See-Insights/Trashcan-Panda-Hardware/Trashcan-Panda-Assembled/IMG_0967.jpeg

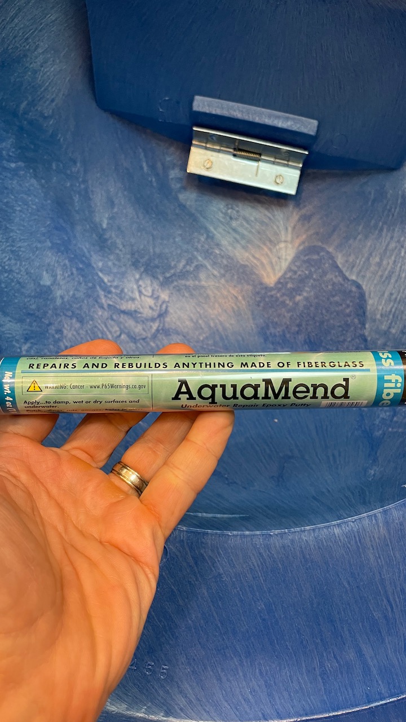
Trashcan-Panda-Assembled/IMG_0967.jpeg
