See-Insights/Trashcan-Panda-Hardware/Trashcan-Panda-Assembled/IMG_0966.jpeg

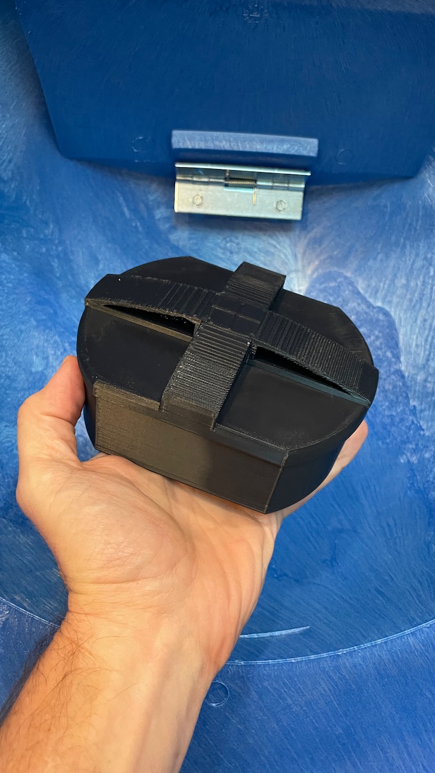
Trashcan-Panda-Assembled/IMG_0966.jpeg
