See-Insights/Trashcan-Panda-Hardware/README.md

# Trashcan-Panda-Hardware
 Trashcan Panda project hardware files
