See-Insights/Trashcan-Panda-Hardware/Trashcan Panda Project Case/images/IMG_1097.png

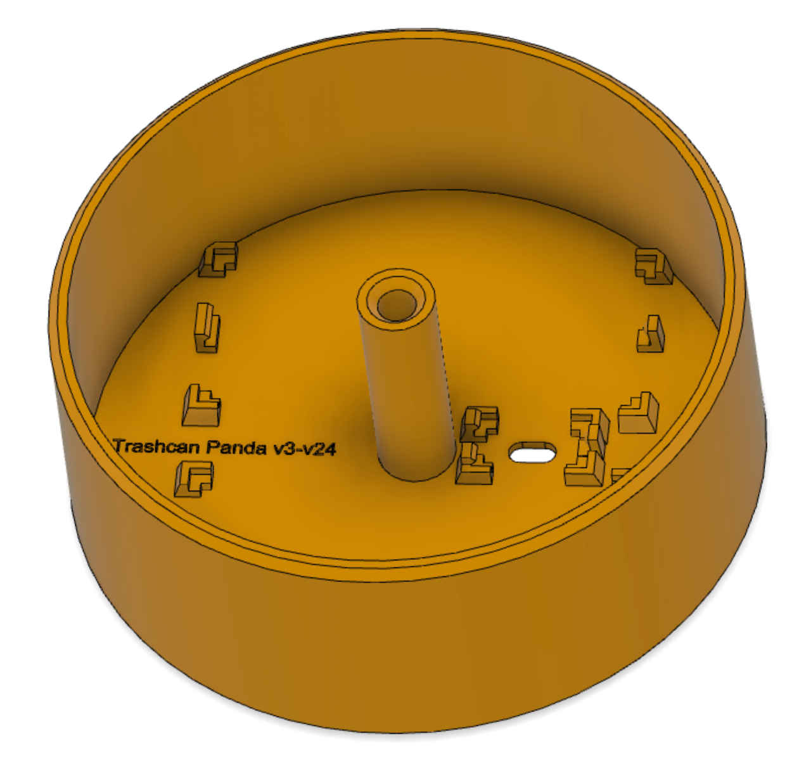
Trashcan Panda Project Case/images/IMG_1097.png
