See-Insights/Trashcan-Panda-Hardware/Trashcan Panda Project Case/images/IMG_5796.png

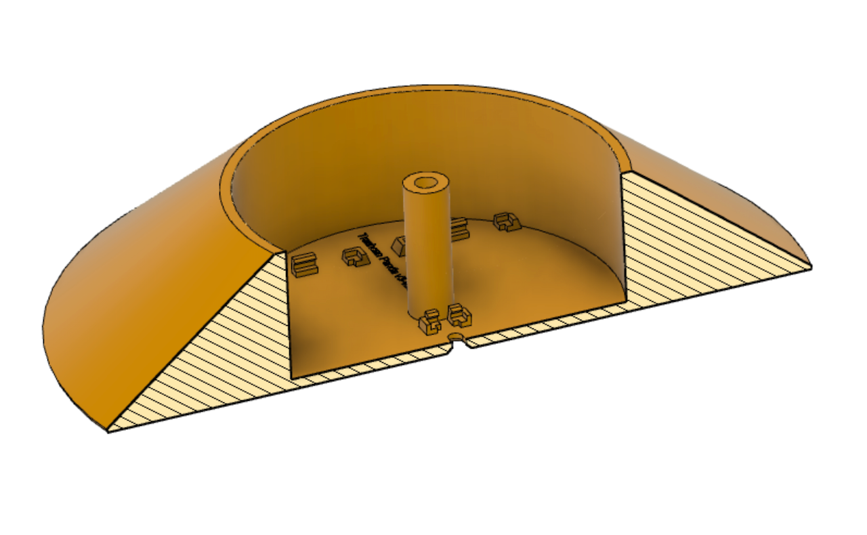
Trashcan Panda Project Case/images/IMG_5796.png
