See-Insights/Trashcan-Panda-Hardware/Trashcan Panda Project Case/images/IMG_8734.png

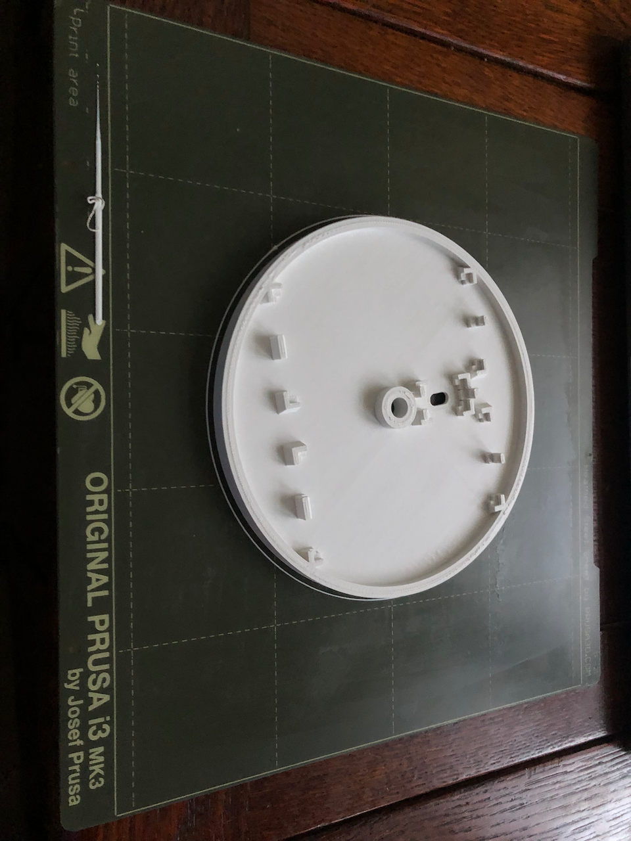
Trashcan Panda Project Case/images/IMG_8734.png
