See-Insights/Trashcan-Panda-Hardware/Trashcan Panda Project Case/images/IMG_8735.png

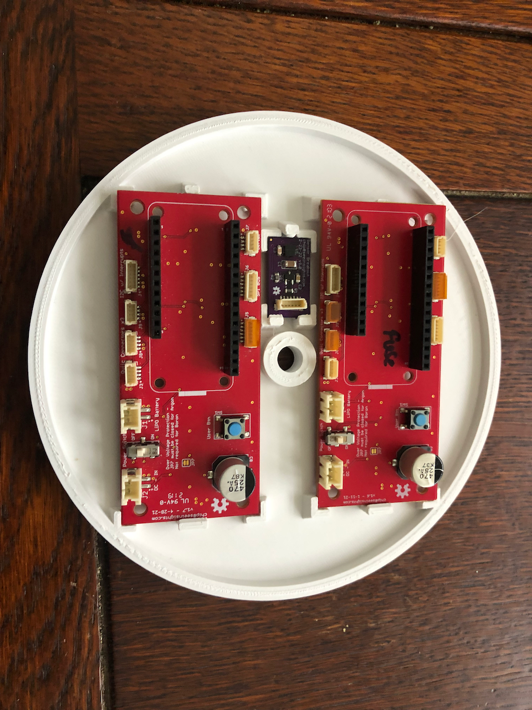
Trashcan Panda Project Case/images/IMG_8735.png
