See-Insights/Trashcan-Panda-Hardware/Trashcan Panda Project Case/images/Screen Shot 2022-02-21 at 4.45.45 PM.png

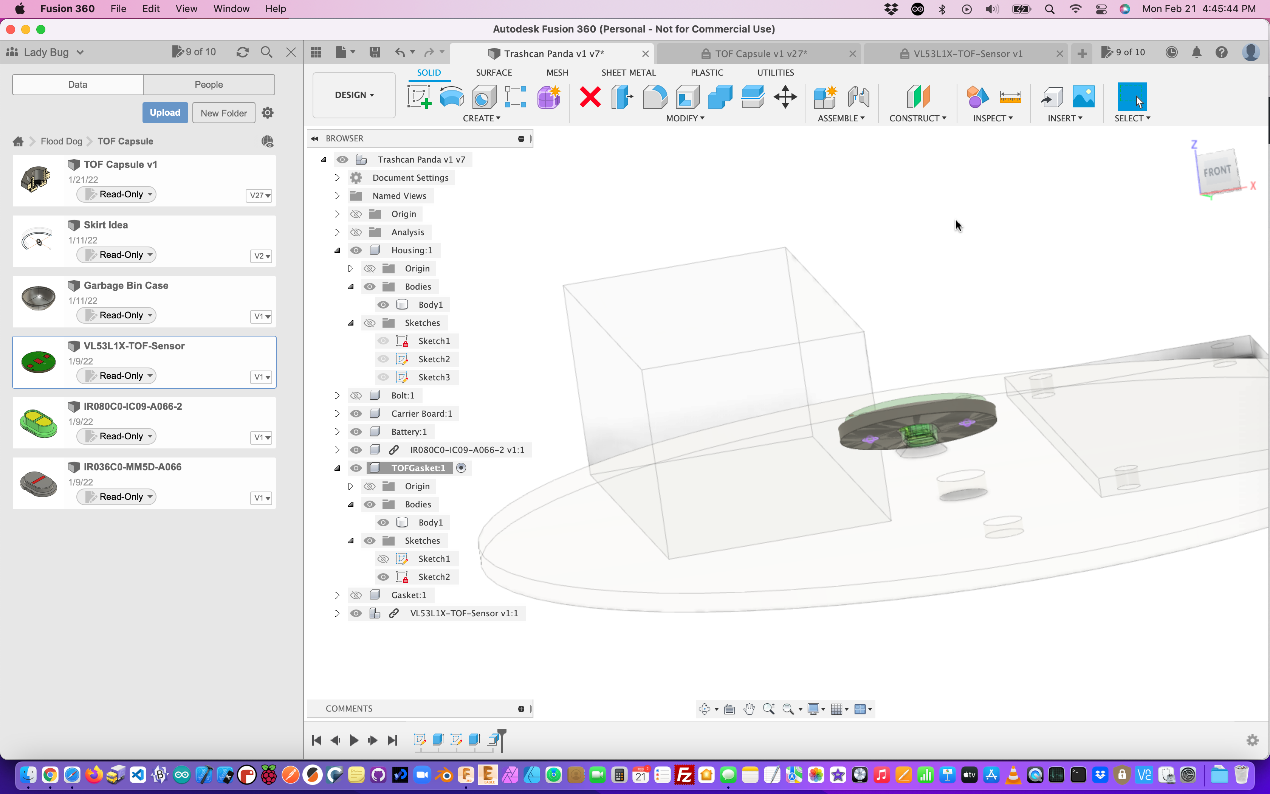
Trashcan Panda Project Case/images/Screen Shot 2022-02-21 at 4.45.45 PM.png
