See-Insights/Trashcan-Panda-Hardware/Trashcan Panda Project Case/images/Screen Shot 2022-02-22 at 7.52.22 AM.png

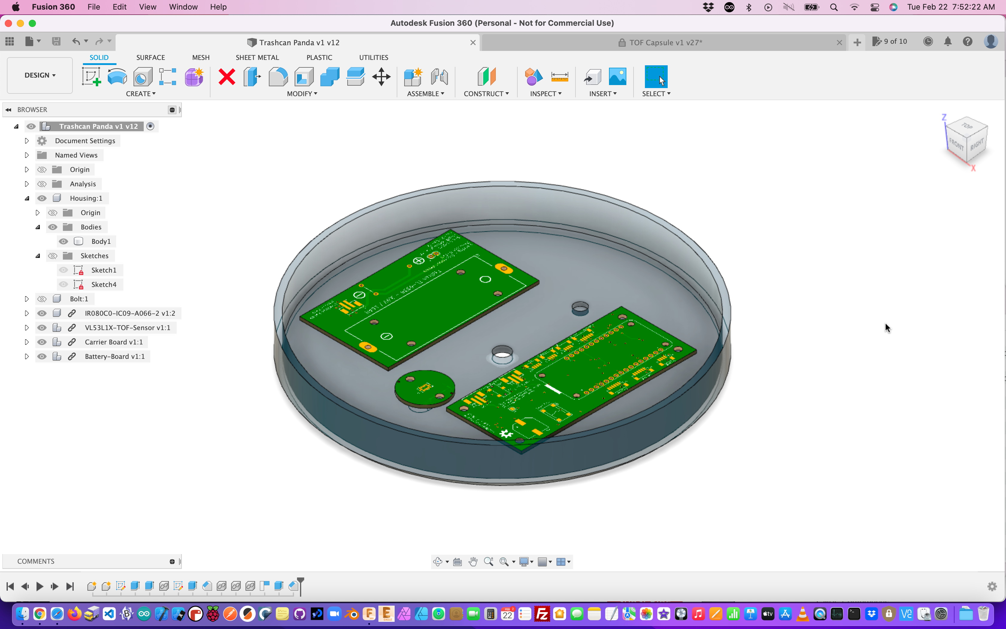
Trashcan Panda Project Case/images/Screen Shot 2022-02-22 at 7.52.22 AM.png
