See-Insights/Trashcan-Panda-Hardware/Trashcan Panda Project Case/images/Screen Shot 2022-02-23 at 12.25.41 PM.png

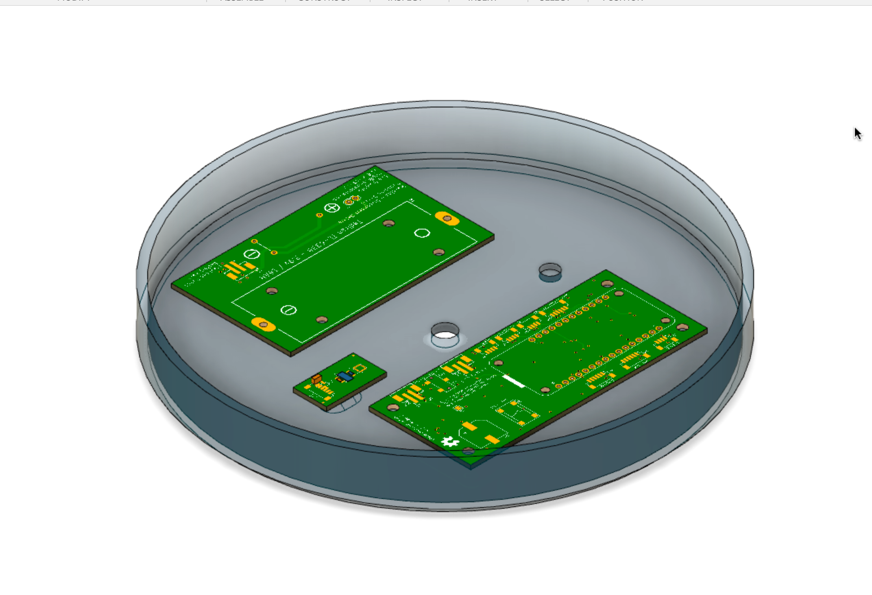
Trashcan Panda Project Case/images/Screen Shot 2022-02-23 at 12.25.41 PM.png
