See-Insights/Trashcan-Panda-Hardware/Trashcan Panda Project Case/images/Screen Shot 2022-02-24 at 10.45.38 AM.png

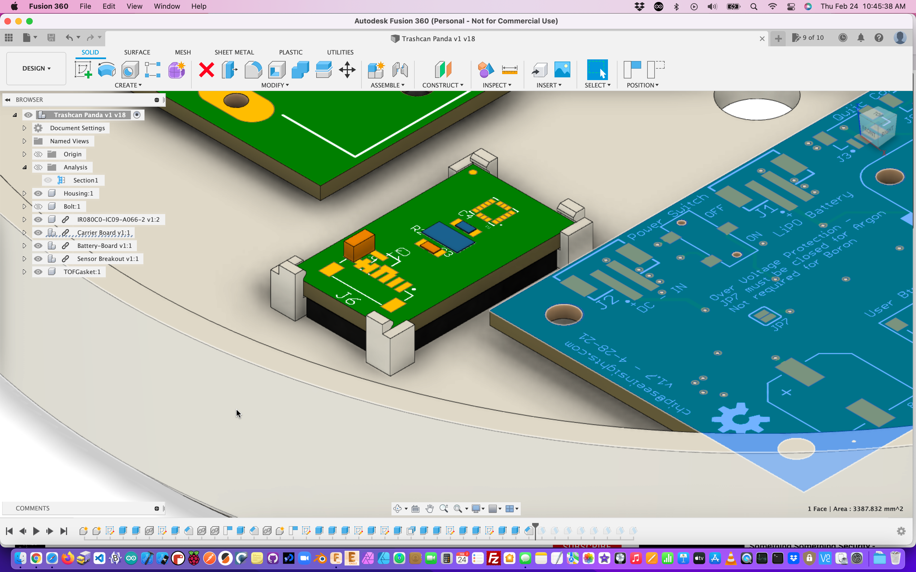
Trashcan Panda Project Case/images/Screen Shot 2022-02-24 at 10.45.38 AM.png
