See-Insights/Trashcan-Panda-Hardware/Trashcan Panda Project Case/images/Screen Shot 2022-02-24 at 10.49.25 AM.png

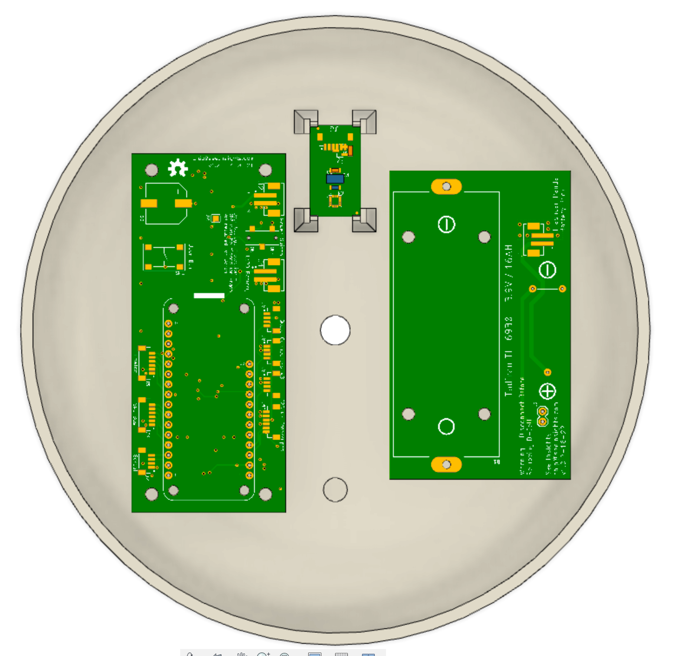
Trashcan Panda Project Case/images/Screen Shot 2022-02-24 at 10.49.25 AM.png
