See-Insights/Trashcan-Panda-Hardware/Trashcan Panda Project Case/images/Screen Shot 2022-02-24 at 11.52.08 AM.png

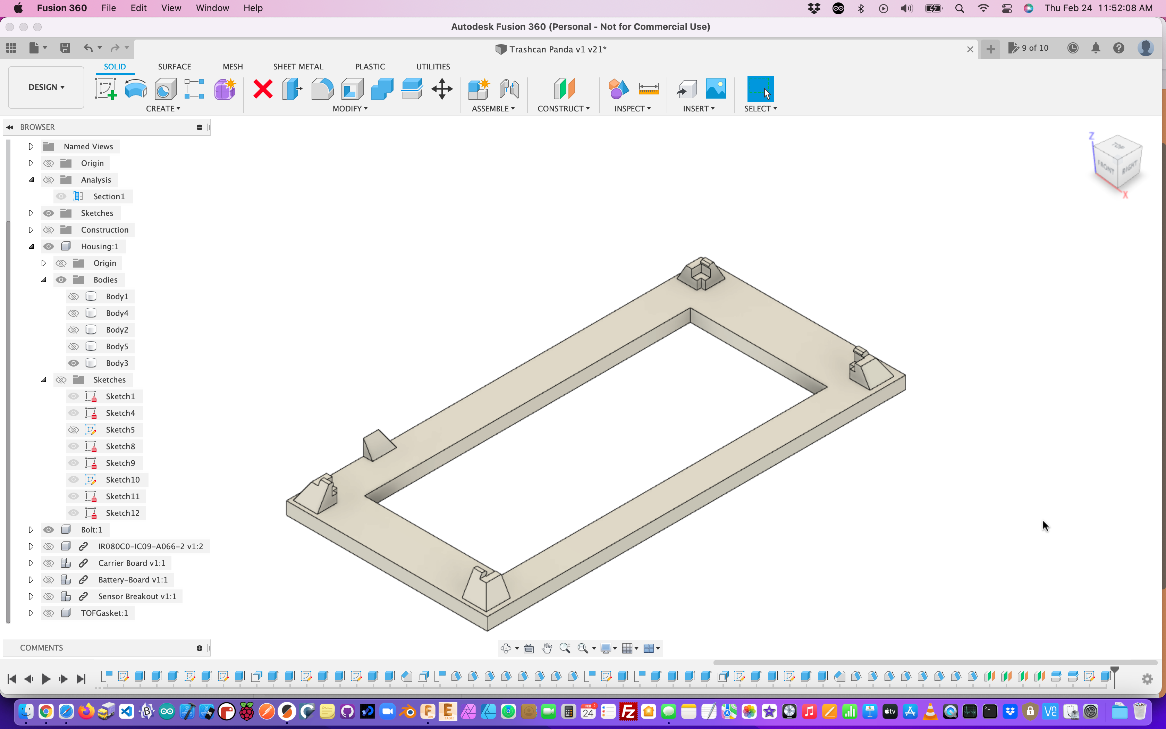
Trashcan Panda Project Case/images/Screen Shot 2022-02-24 at 11.52.08 AM.png
