See-Insights/Trashcan-Panda-Hardware/Trashcan Panda Project Case/images/Screen Shot 2022-02-25 at 9.09.44 AM.png

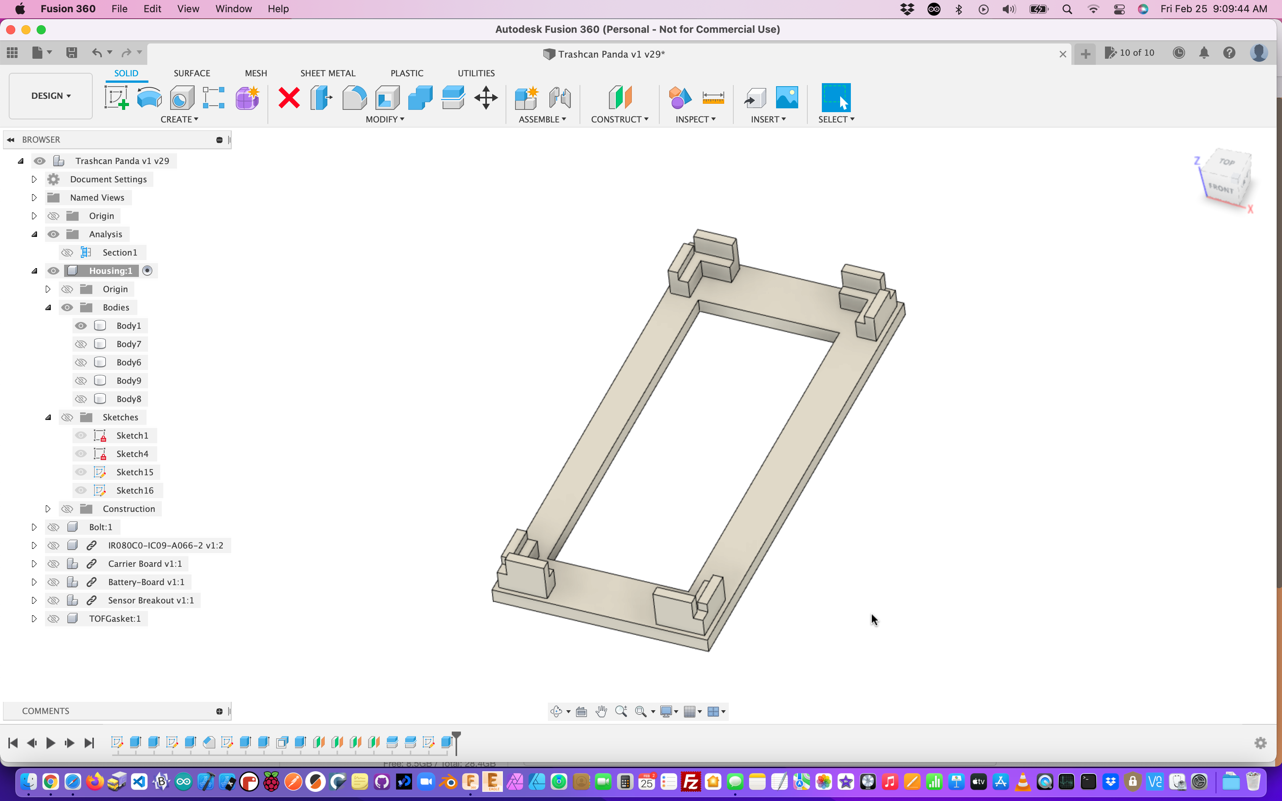
Trashcan Panda Project Case/images/Screen Shot 2022-02-25 at 9.09.44 AM.png
