See-Insights/Trashcan-Panda-Hardware/Trashcan Panda Project Case/images/Screen Shot 2022-02-26 at 8.32.29 AM.png

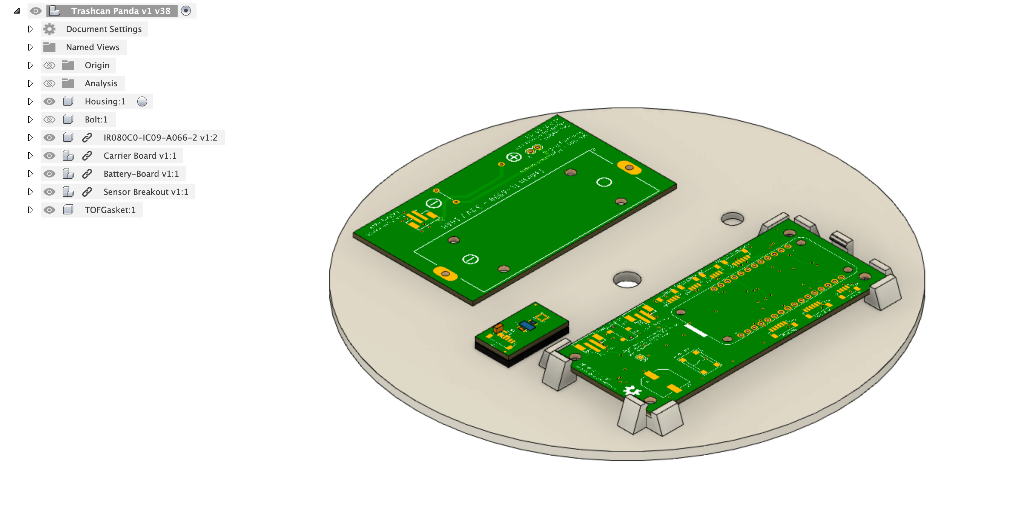
Trashcan Panda Project Case/images/Screen Shot 2022-02-26 at 8.32.29 AM.png
