See-Insights/Trashcan-Panda-Hardware/Trashcan-Panda Sensor-Board/Sensor Breakout Bottom.png

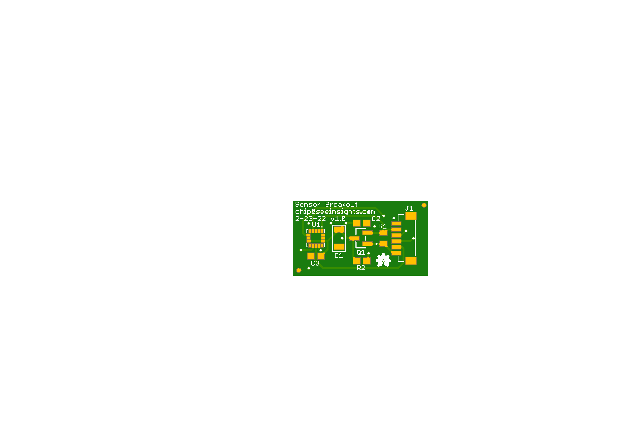
Trashcan-Panda Sensor-Board/Sensor Breakout Bottom.png
