See-Insights/Trashcan-Panda-Hardware/Trashcan-Panda Sensor-Board/Sensor Breakout Top Board.png

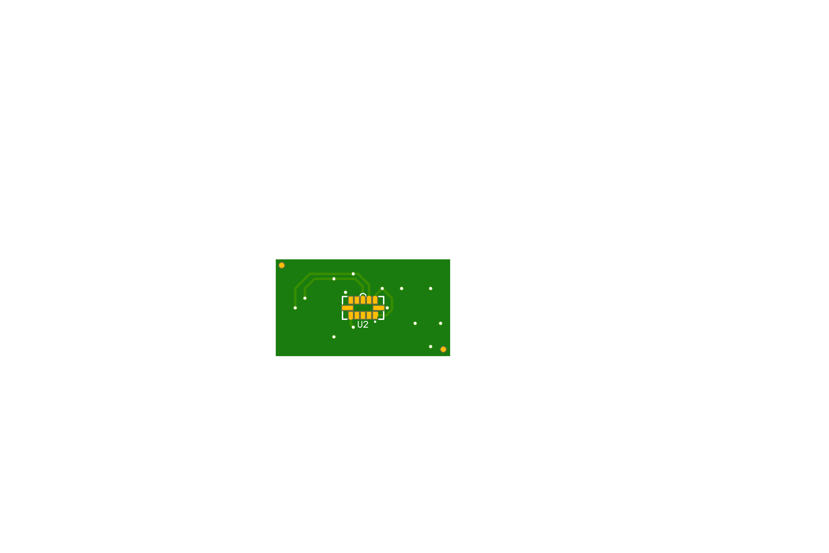
Trashcan-Panda Sensor-Board/Sensor Breakout Top Board.png
