See-Insights/Trashcan-Panda-Hardware/Trashcan Panda Project Case/Trashcan Panda v6 v27.3mf

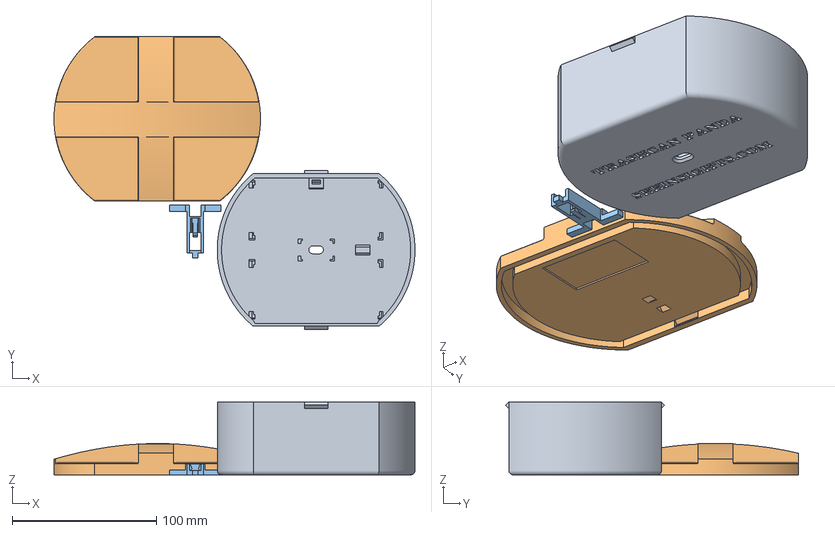
[picture p22: CAD file, 2022-05-29]
Trashcan Panda Project Case/Trashcan Panda v6 v27.3mf
250.0 x 202.6 x 50.4 mm
Housing
Lid
T Bracket
