See-Insights/Trashcan-Panda-Hardware/Trashcan Panda v6 v4.3mf

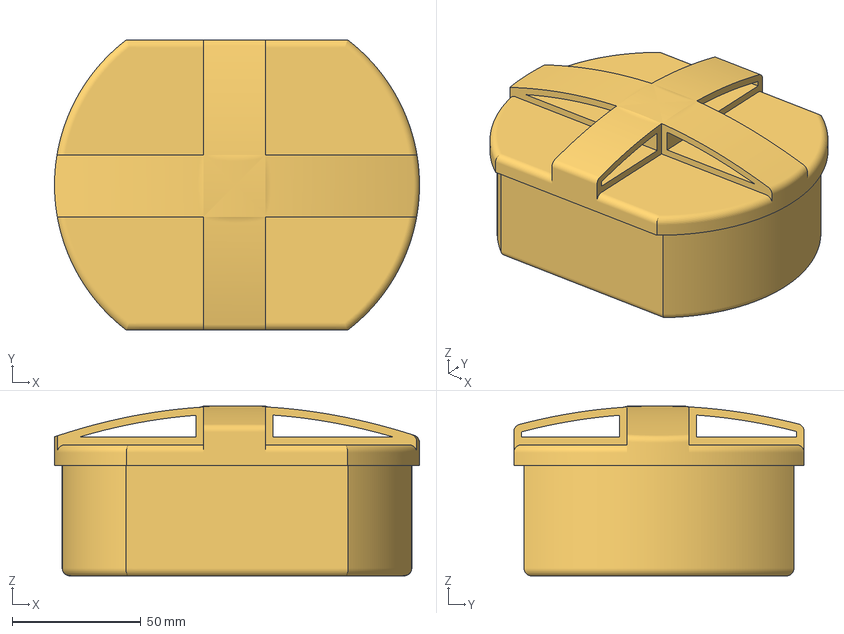
[picture p23: CAD file, 2022-05-03]
Trashcan Panda v6 v4.3mf
142.0 x 113.0 x 66.1 mm
Housing
Lid Seal
Lid
T Bracket
TOF Gasket
