See-Insights/Trashcan-Panda-Hardware/Trashcan-Panda Sensor-Board/3D Models/VL53L1CBV0FY-1--3DModel-STEP-269445.STEP

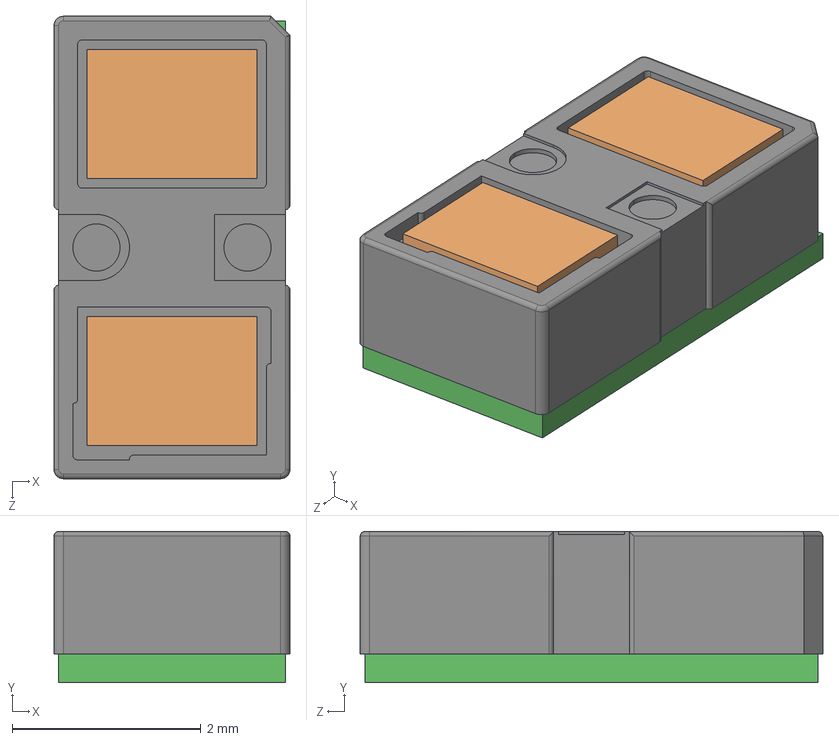
[picture p24: CAD file, 2022-02-18]
Trashcan-Panda Sensor-Board/3D Models/VL53L1CBV0FY-1--3DModel-STEP-269445.STEP
2.50 x 1.60 x 4.90 mm
