See-Insights/Trashcan-Panda-Hardware/Trashcan Panda Project Case/Trashcan Panda v6 Flat Lid v27.3mf

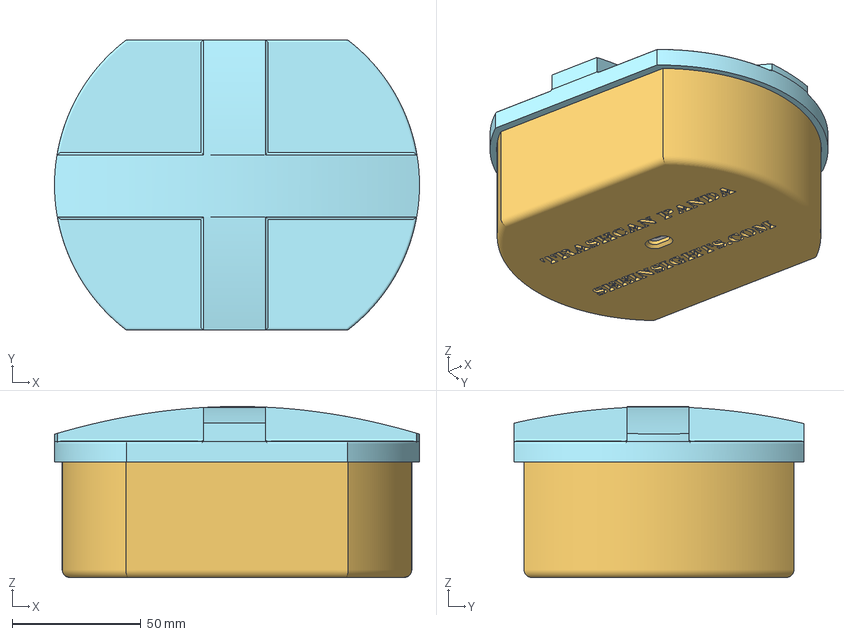
[picture p25: CAD file, 2022-05-29]
Trashcan Panda Project Case/Trashcan Panda v6 Flat Lid v27.3mf
142.0 x 113.0 x 66.5 mm
Battery Brace
Housing
Lid (3)
Lid Seal
Lid
T Bracket
TOF Gasket
