See-Insights/Trashcan-Panda-Hardware/Trashcan Panda Project Case/Trashcan Panda v6 v6.3mf

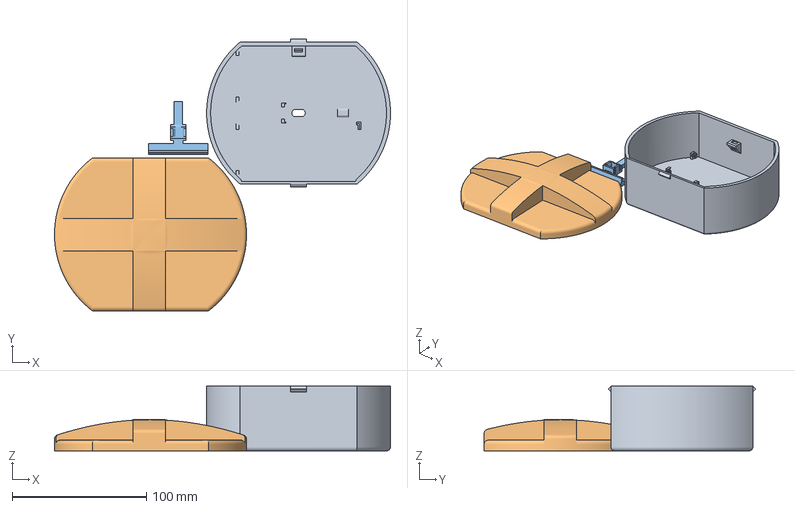
[picture p26: CAD file, 2022-05-04]
Trashcan Panda Project Case/Trashcan Panda v6 v6.3mf
250.0 x 202.1 x 48.3 mm
Housing
Lid
T Bracket
