See-Insights/Trashcan-Panda-Hardware/Trashcan Panda Project Case/Trashcan Panda v6 v4.3mf

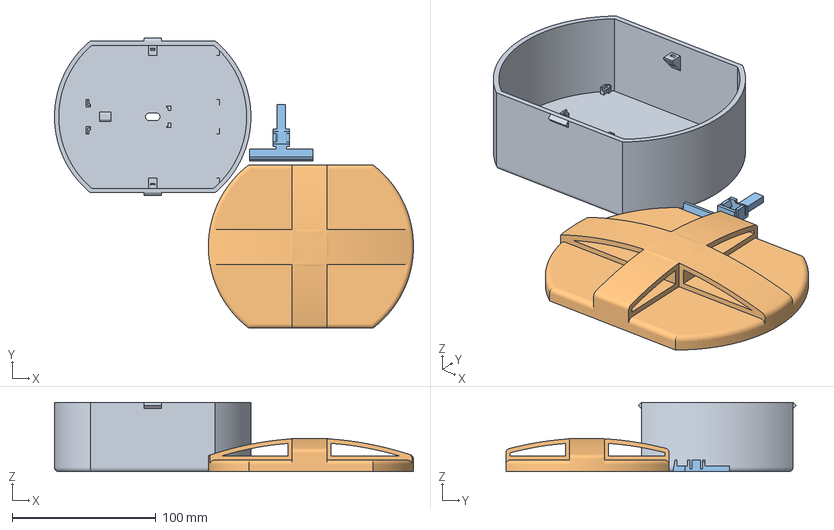
[picture p27: CAD file, 2022-05-03]
Trashcan Panda Project Case/Trashcan Panda v6 v4.3mf
250.0 x 202.1 x 48.3 mm
Housing
Lid
T Bracket
