See-Insights/Trashcan-Panda-Hardware/Trashcan Panda Project Case/Trashcan Panda v4 v12.3mf

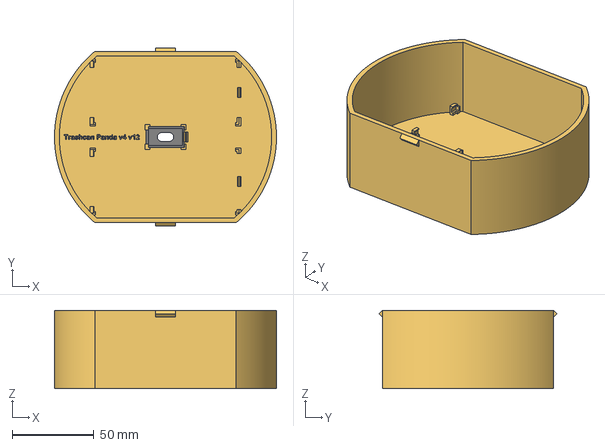
[picture p28: CAD file, 2022-04-23]
Trashcan Panda Project Case/Trashcan Panda v4 v12.3mf
136.0 x 109.2 x 48.0 mm
Housing
TOF Gasket
