See-Insights/Trashcan-Panda-Hardware/Trashcan Panda Project Case/Mount.3mf

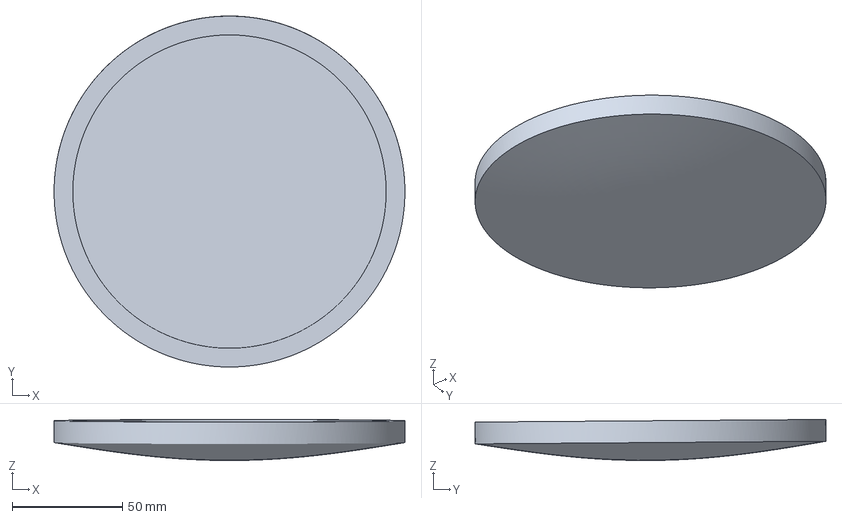
[picture p29: CAD file, 2022-04-11]
Trashcan Panda Project Case/Mount.3mf
159.0 x 159.1 x 18.6 mm
