See-Insights/Trashcan-Panda-Hardware/Trashcan Panda Project Case/Trashcan Panda v3 v28.3mf

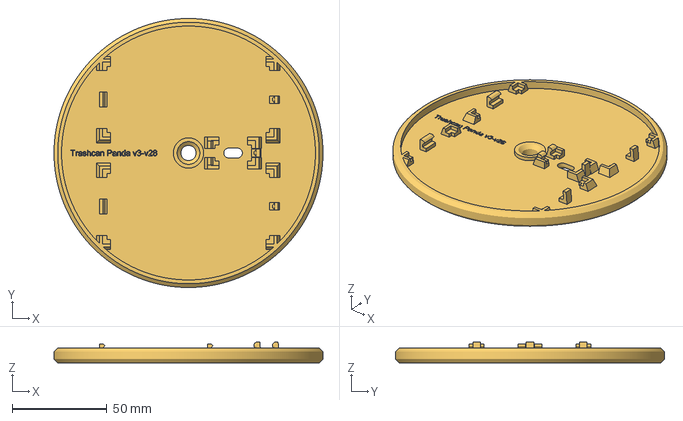
[picture p30: CAD file, 2022-04-09]
Trashcan Panda Project Case/Trashcan Panda v3 v28.3mf
142.0 x 142.0 x 11.0 mm
