See-Insights/Trashcan-Panda-Hardware/Trashcan Panda Project Case/Trashcan Panda v3 v5.3mf

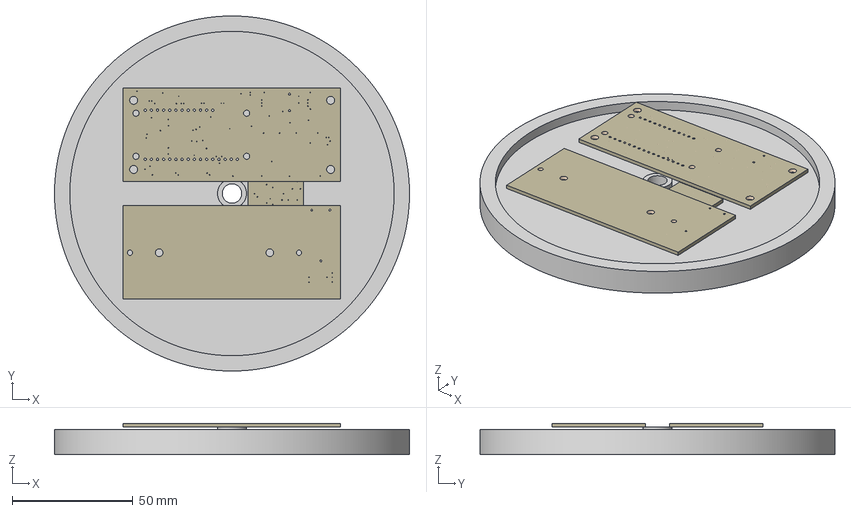
[picture p31: CAD file, 2022-03-21]
Trashcan Panda Project Case/Trashcan Panda v3 v5.3mf
146.7 x 146.7 x 12.9 mm
Board x 3
Housing
