See-Insights/Trashcan-Panda-Hardware/Trashcan Panda Project Case/Trashcan Panda v2 v9.3mf

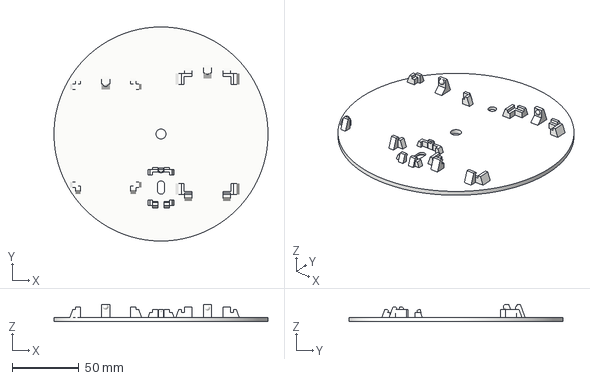
[picture p32: CAD file, 2022-03-16]
Trashcan Panda Project Case/Trashcan Panda v2 v9.3mf
160.0 x 160.0 x 13.0 mm
