See-Insights/Trashcan-Panda-Hardware/Trashcan Panda Project Case/Trashcan Panda v1 v12.3mf

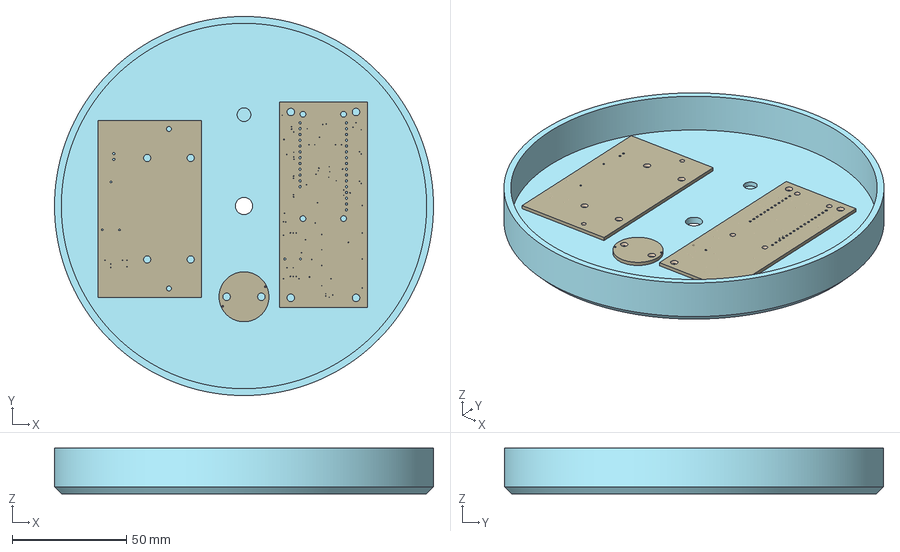
[picture p33: CAD file, 2022-02-23, an earlier design]
Trashcan Panda Project Case/Trashcan Panda v1 v12.3mf
166.0 x 166.0 x 20.0 mm
0805@1 x 7
Board x 3
CAPC2012X100N
MICRO-FIDUCIAL x 4
PANASONIC_SMINI2-F5-B
QFN_16_ABR
RJ_5_ADI
SOD-123 x 2
SON50P200X300X75-9N
SOT-23-5
SOT-23_3L_ONS
SOT-23_3L_ONS-M x 2
SOT-25_TOR
SSP-T7-F_EPS
