See-Insights/Trashcan-Panda-Hardware/Trashcan Panda Project Case/Trashcan Panda v1 v6.3mf

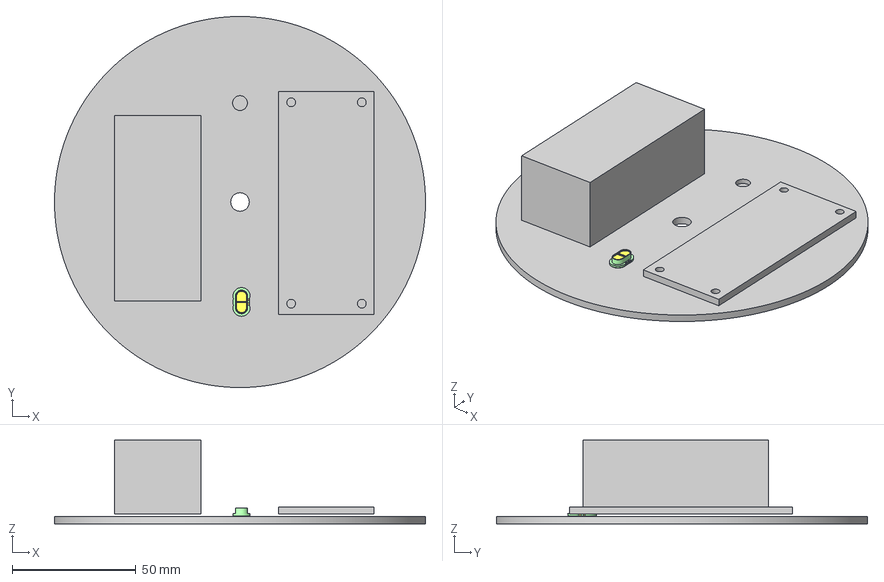
[picture p34: CAD file, 2022-02-18, an earlier design]
Trashcan Panda Project Case/Trashcan Panda v1 v6.3mf
150.0 x 150.0 x 33.9 mm
