See-Insights/Trashcan-Panda-Hardware/(list of files, cad)

Other CAD files:
Trashcan Panda Project Case/Trashcan Panda v6 v3.3mf
Trashcan Panda Project Case/Trashcan Panda v1 v12.f3z
Trashcan Panda Project Case/Trashcan Panda v1 v39.f3z
Trashcan Panda Project Case/Trashcan Panda v1 v6.f3z
Trashcan Panda Project Case/Trashcan Panda v2 v9.f3z
Trashcan Panda Project Case/Trashcan Panda v6 v28.f3z
Trashcan Panda Project Case/Trashcan Panda v6 v3.f3z
Trashcan Panda Project Case/Trashcan Panda v6 v4.f3z
Trashcan Panda Project Case/Trashcan Panda v6 v6.f3z
Trashcan-Panda Sensor-Board/3D Models/TOF Capsule v1 v8.f3z
