See-Insights/Trashcan-Panda-Hardware/Trashcan-Panda-Assembled/IMG_0960.jpeg

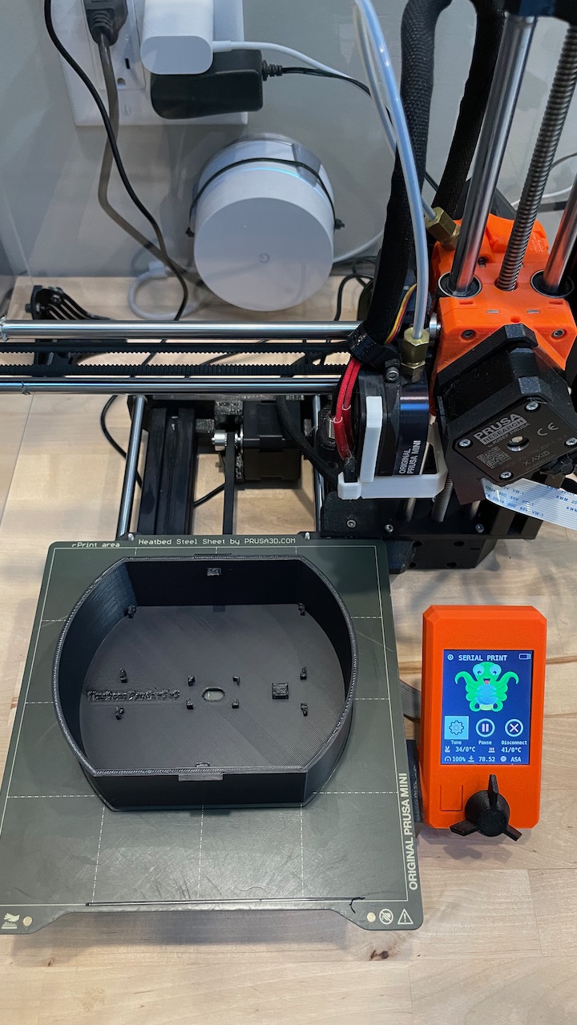
Trashcan-Panda-Assembled/IMG_0960.jpeg
