See-Insights/Trashcan-Panda-Hardware/Trashcan-Panda-Assembled/IMG_0965.jpeg

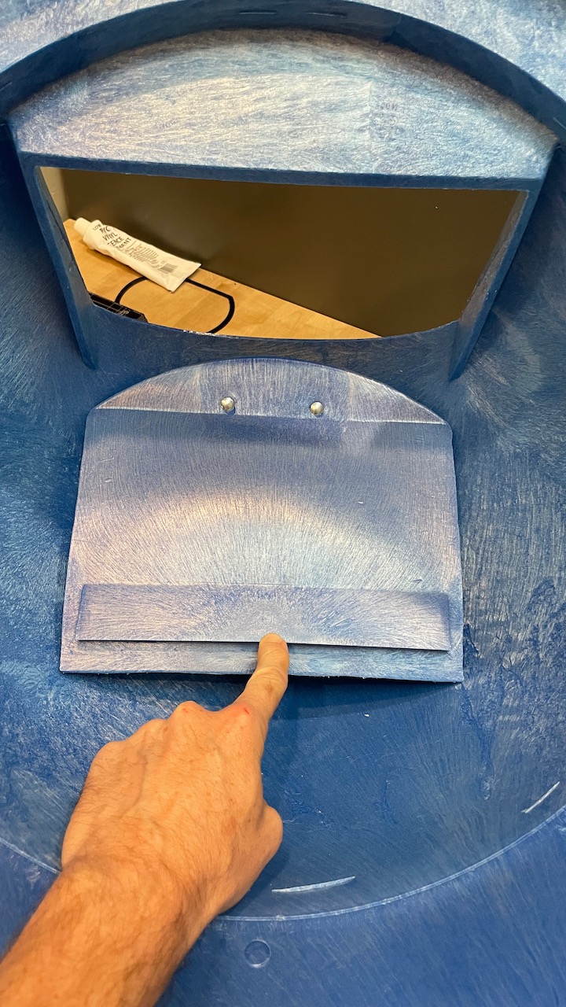
Trashcan-Panda-Assembled/IMG_0965.jpeg
