See-Insights/Trashcan-Panda-Hardware/Trashcan-Panda-Assembled/IMG_0968.jpeg

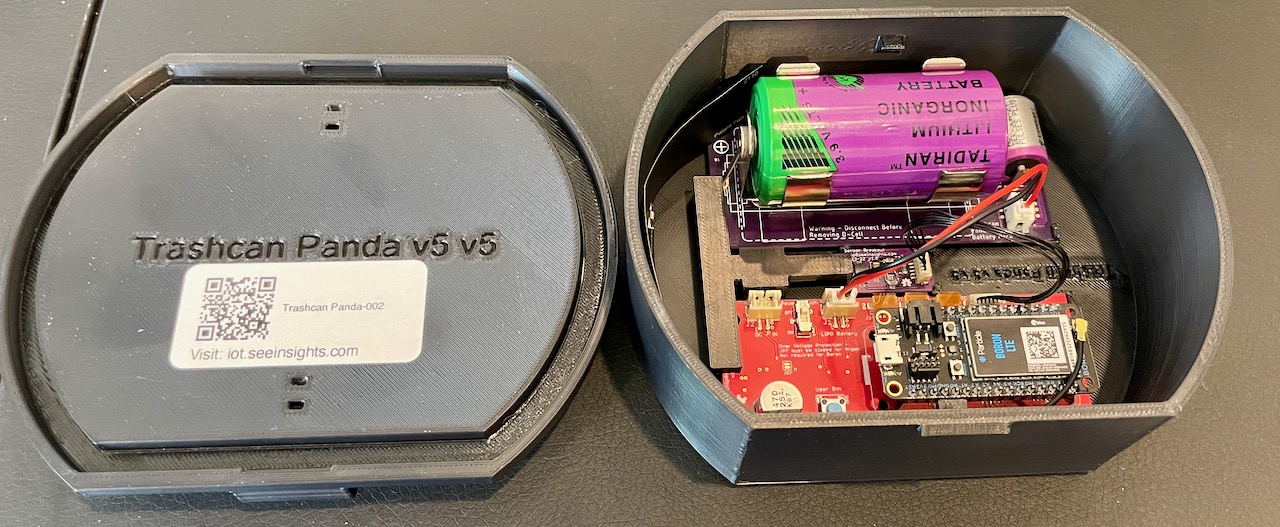
Trashcan-Panda-Assembled/IMG_0968.jpeg
