See-Insights/Trashcan-Panda-Hardware/Trashcan-Panda-Assembled/IMG_0969.jpeg

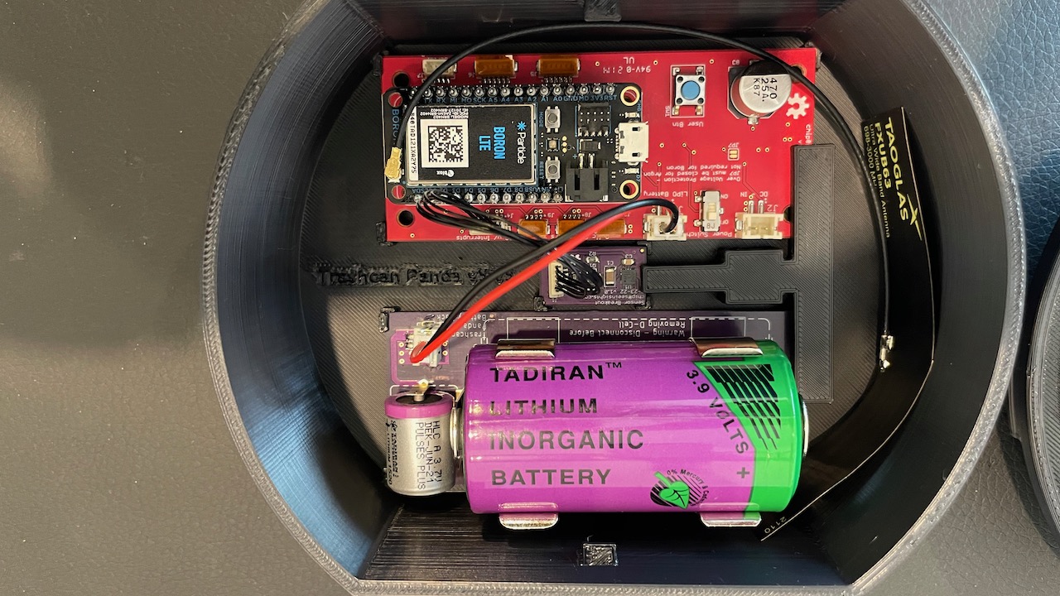
Trashcan-Panda-Assembled/IMG_0969.jpeg
