See-Insights/Trashcan-Panda-Hardware/Trashcan-Panda-Assembled/IMG_0970.jpeg

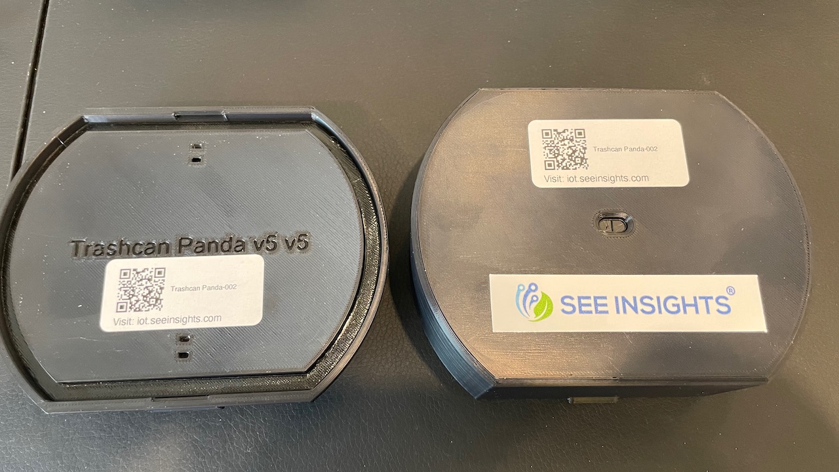
Trashcan-Panda-Assembled/IMG_0970.jpeg
