See-Insights/Trashcan-Panda-Hardware/Trashcan-Panda-Assembled/IMG_0971.jpeg

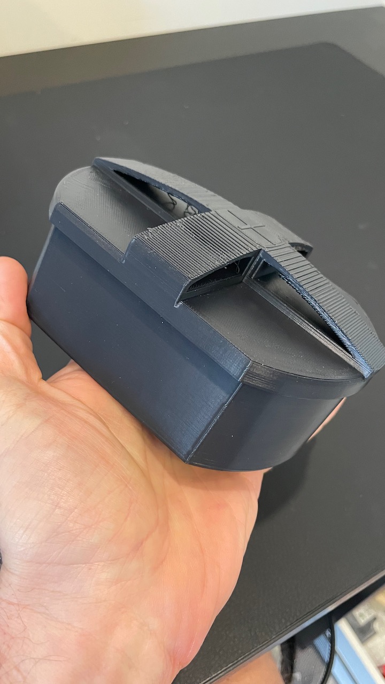
Trashcan-Panda-Assembled/IMG_0971.jpeg
