See-Insights/Trashcan-Panda-Hardware/Trasncan-Panda-Carrier-Board/Carrier Board Schematic.pdf

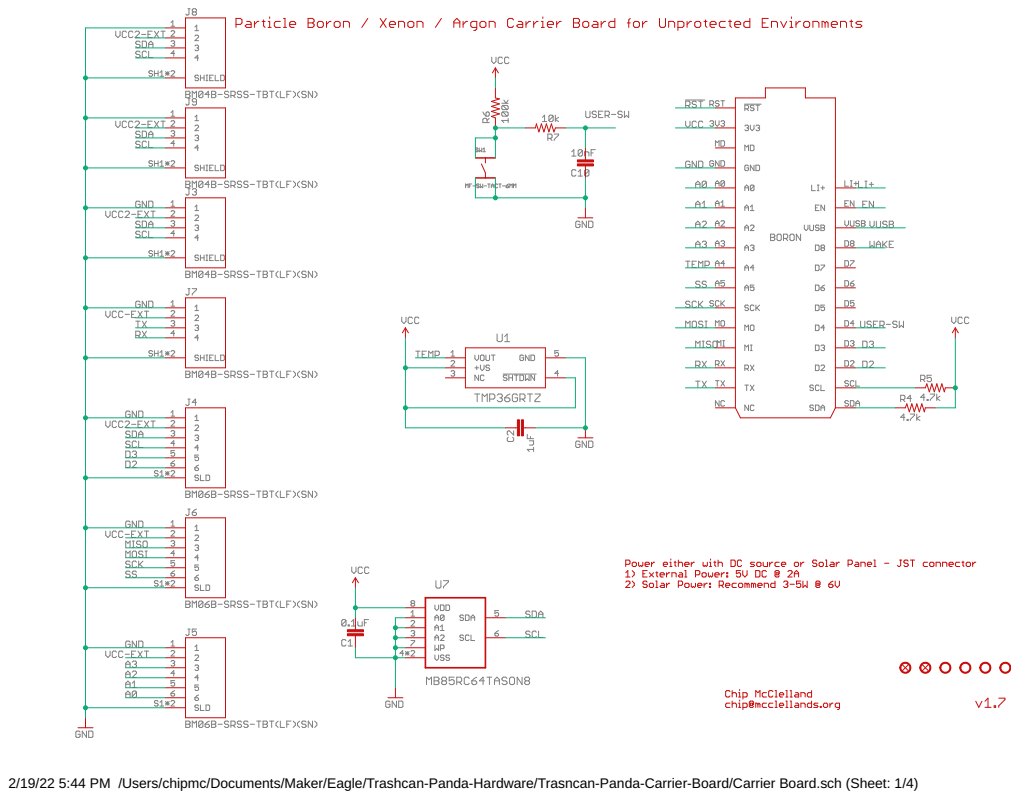
[picture p41: page 1]

2/19/22 5:44 PM /Users/chipmc/Documents/Maker/Eagle/Trashcan-Panda-Hardware/Trasncan-Panda-Carrier-Board/Carrier Board.sch (Sheet: 1/4)

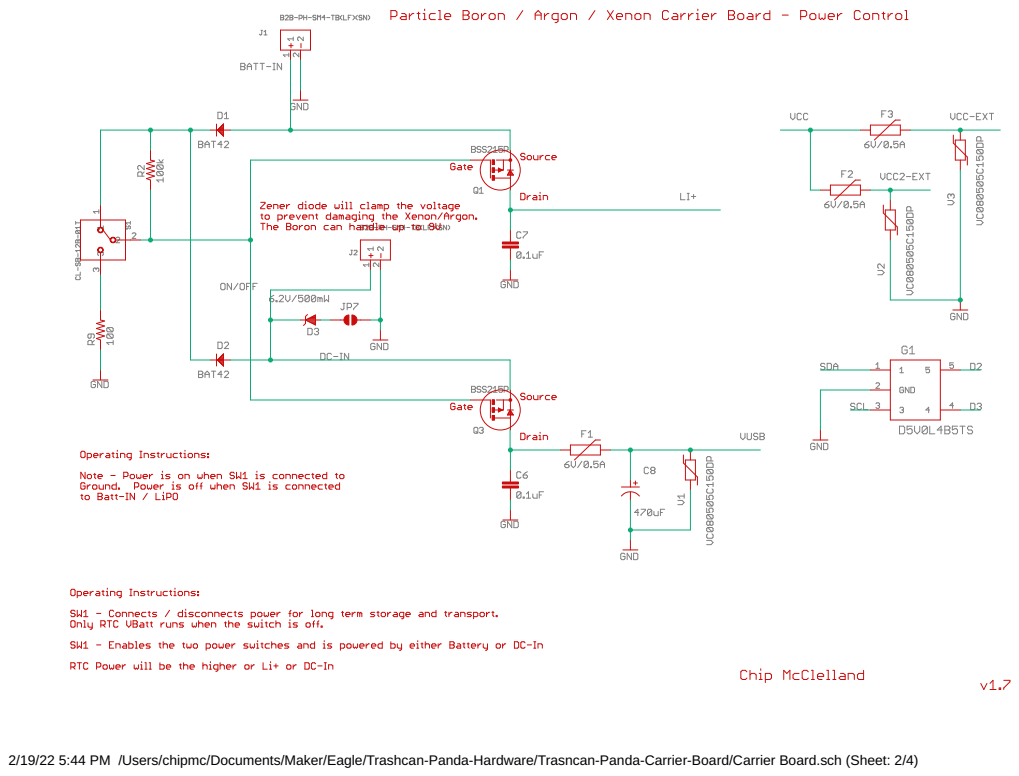
[picture p42: page 2]

2/19/22 5:44 PM /Users/chipmc/Documents/Maker/Eagle/Trashcan-Panda-Hardware/Trasncan-Panda-Carrier-Board/Carrier Board.sch (Sheet: 2/4)

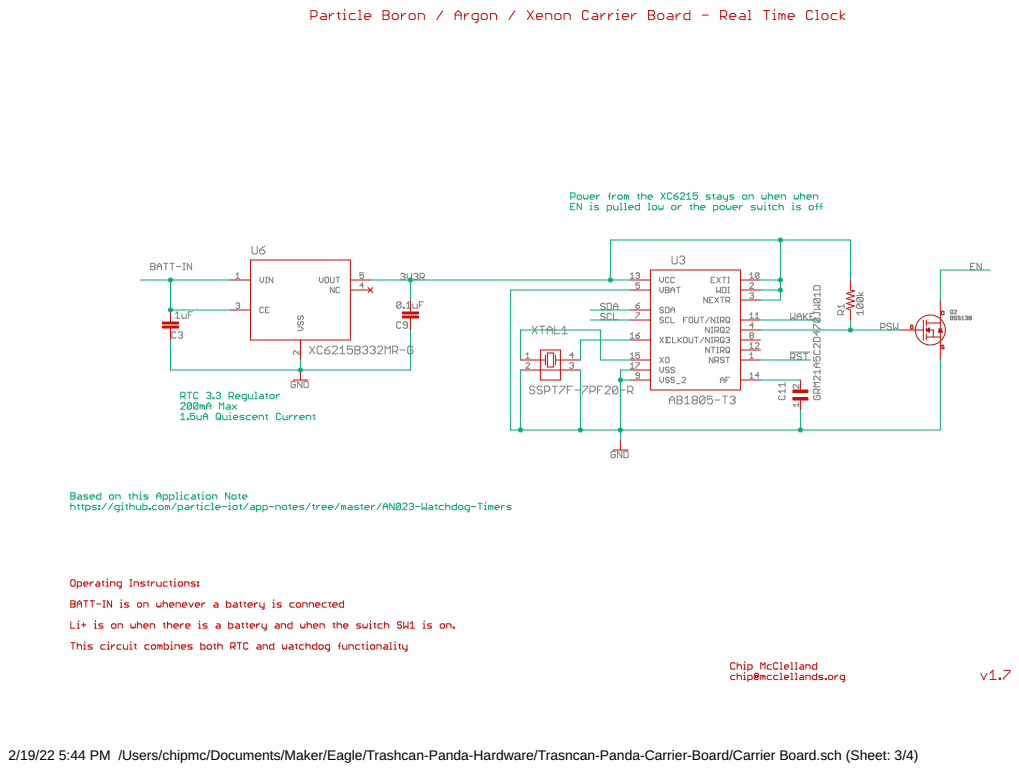
[picture p43: page 3]

2/19/22 5:44 PM /Users/chipmc/Documents/Maker/Eagle/Trashcan-Panda-Hardware/Trasncan-Panda-Carrier-Board/Carrier Board.sch (Sheet: 3/4)

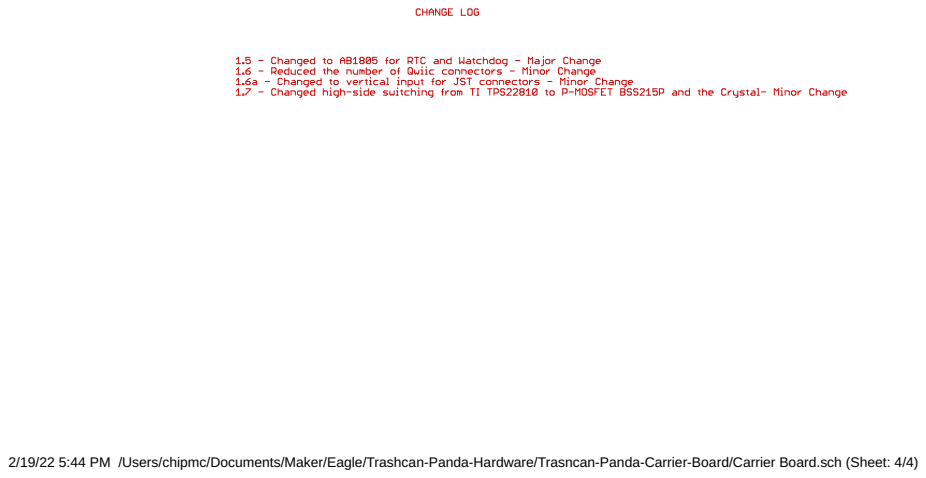
[picture p44: page 4]

2/19/22 5:44 PM /Users/chipmc/Documents/Maker/Eagle/Trashcan-Panda-Hardware/Trasncan-Panda-Carrier-Board/Carrier Board.sch (Sheet: 4/4)
