See-Insights/Trashcan-Panda-Hardware/Trashcan-Panda Sensor-Board/Sensor Breakout.pdf

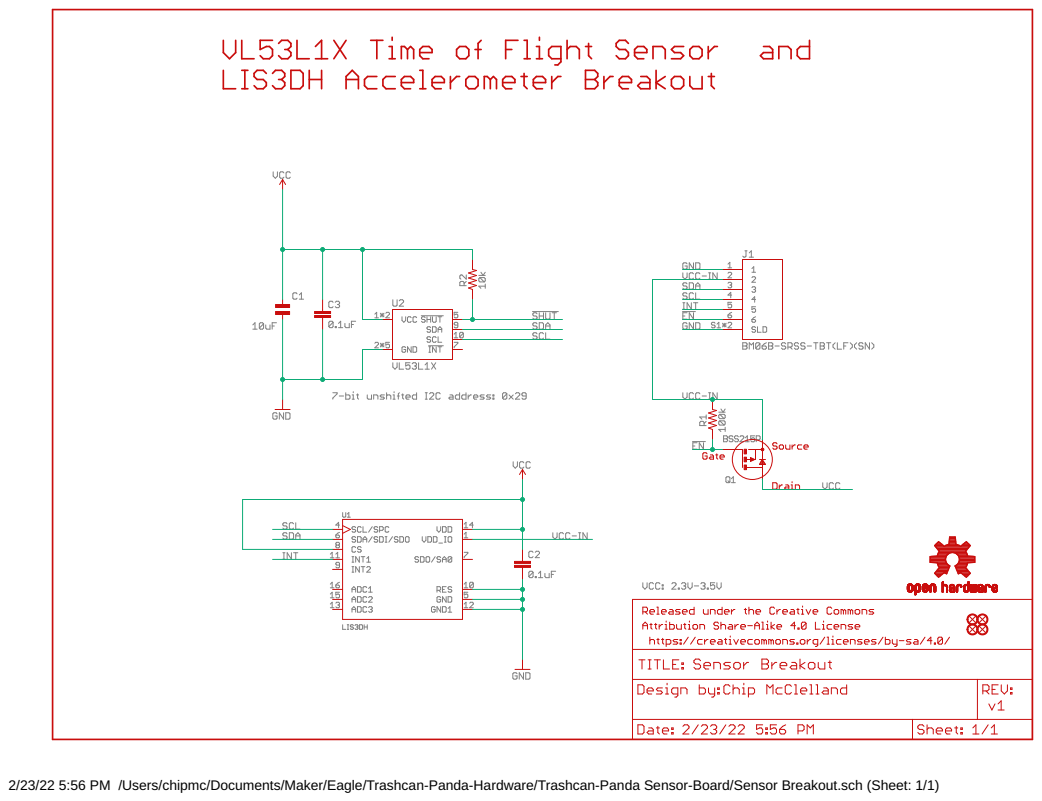
[picture p45: page 1]

2/23/22 5:56 PM /Users/chipmc/Documents/Maker/Eagle/Trashcan-Panda-Hardware/Trashcan-Panda Sensor-Board/Sensor Breakout.sch (Sheet: 1/1)
