See-Insights/Trashcan-Panda-Hardware/Trasncan-Panda-Carrier-Board/Carrier Board Layout.pdf

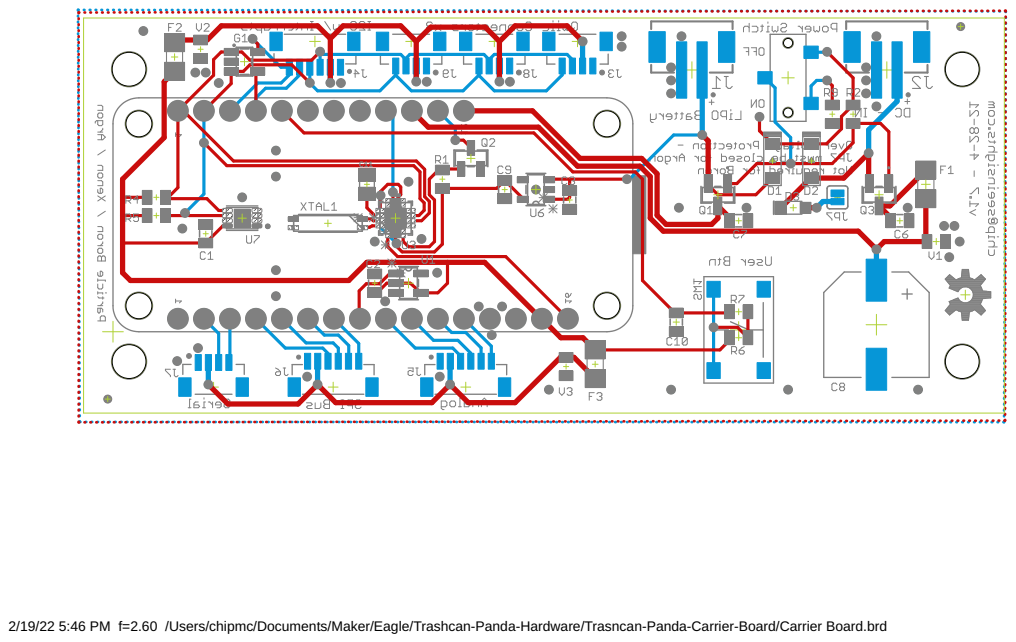
[picture p46: page 1]

2/19/22 5:46 PM f=2.60 /Users/chipmc/Documents/Maker/Eagle/Trashcan-Panda-Hardware/Trasncan-Panda-Carrier-Board/Carrier Board.brd
