See-Insights/Trashcan-Panda-Hardware/Trashcan-Panda-Battery-Board/Battery-Board.brd

## EAGLE design Trashcan-Panda-Battery-Board/Battery-Board.brd (2022-04-09)

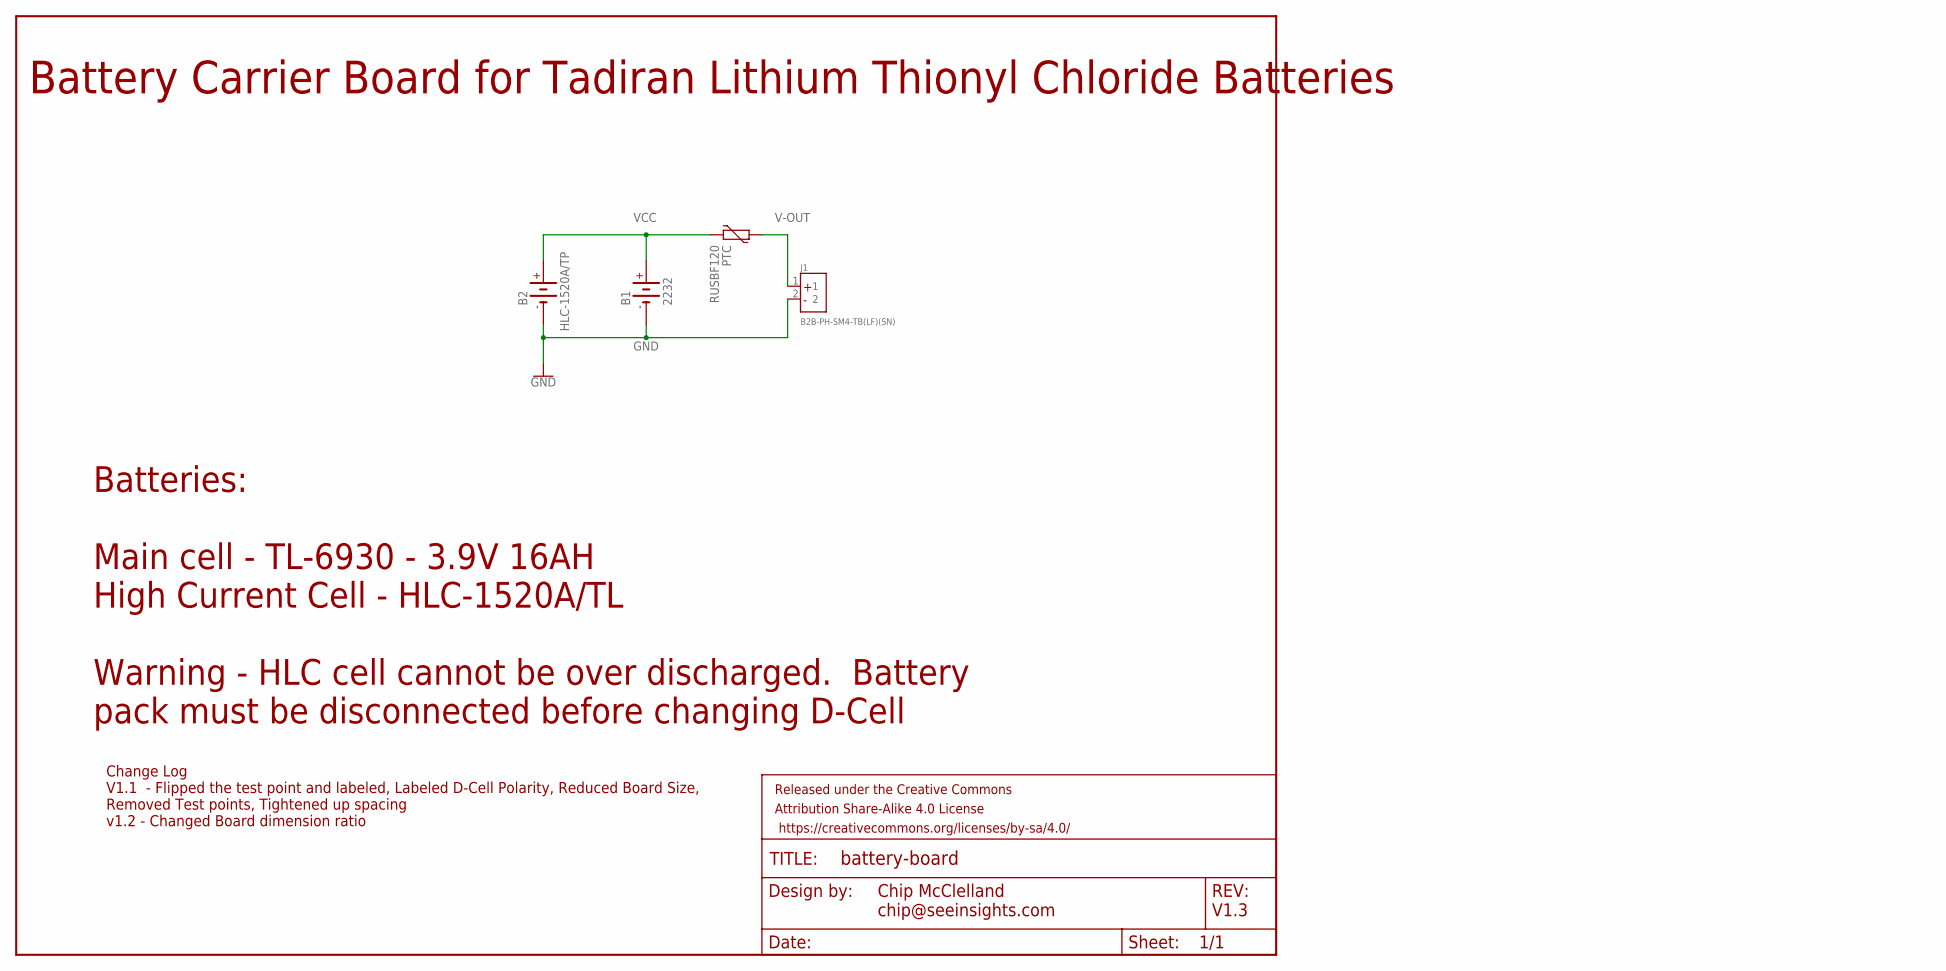
[picture p47: schematic Battery-Board.sch]

Parts:
B1: 2232
B2: HLC-1520A/TP
FRAME1: FRAME-LETTER; CREATIVE_COMMONS
J1: B2B-PH-SM4-TB(LF)(SN); JST_B2B-PH-SM4-TB(LF)(SN)
PTC: RUSBF120; PTC-RUSBF120

Connections:
GND: B1.-, B2.-, B2.-- (-), J1.2
V-OUT: J1.1, PTC.2
VCC: B1.+, B2.+, PTC.1

Notes on the sheet:
Battery Carrier Board for Tadiran Lithium Thionyl Chloride Batteries
Batteries: Main cell - TL-6930 - 3.9V 16AH High Current Cell - HLC-1520A/TL Warning - HLC cell cannot be over discharged. Battery pack must be disconnected before changing D-Cell
Chip McClelland chip@seeinsights.com
V1.3
Change Log V1.1 - Flipped the test point and labeled, Labeled D-Cell Polarity, Reduced Board Size, Removed Test points, Tightened up spacing v1.2 - Changed Board dimension ratio

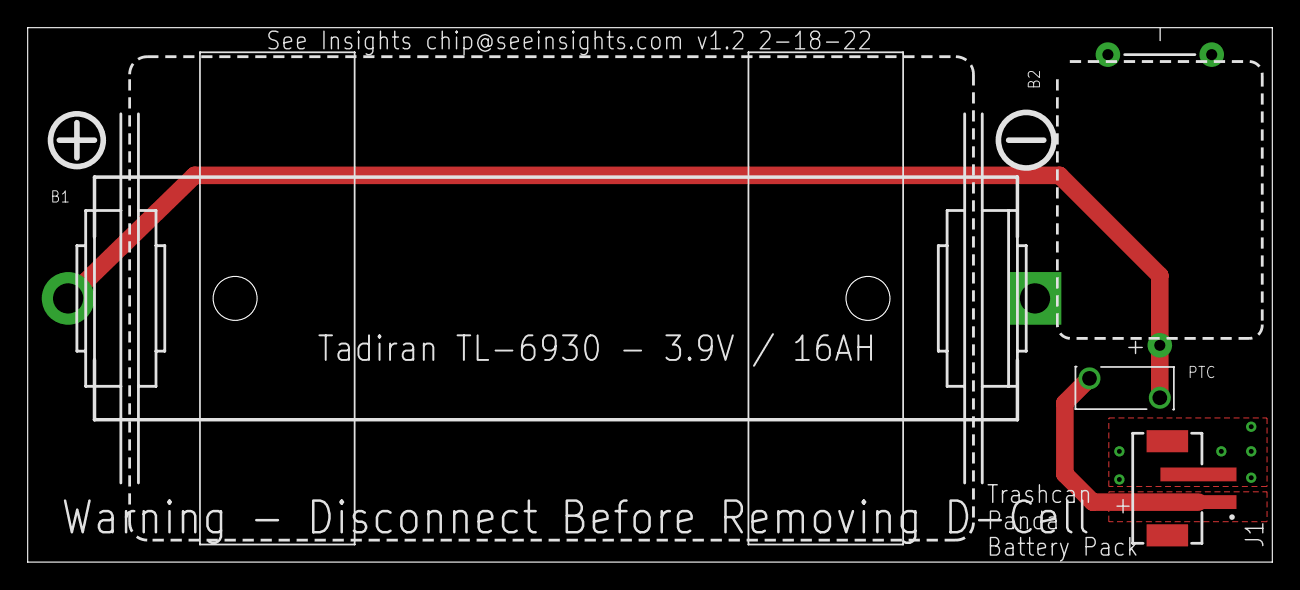
[picture p48: board Battery-Board.brd from above]

Board: 2 copper layers, 89.9 x 38.6 mm, 5 parts (0 on the bottom side), 3 nets.
