See-Insights/Trashcan-Panda-Hardware/Trashcan-Panda Sensor-Board/Sensor Breakout.brd

## EAGLE design Trashcan-Panda Sensor-Board/Sensor Breakout.brd (2022-04-09)

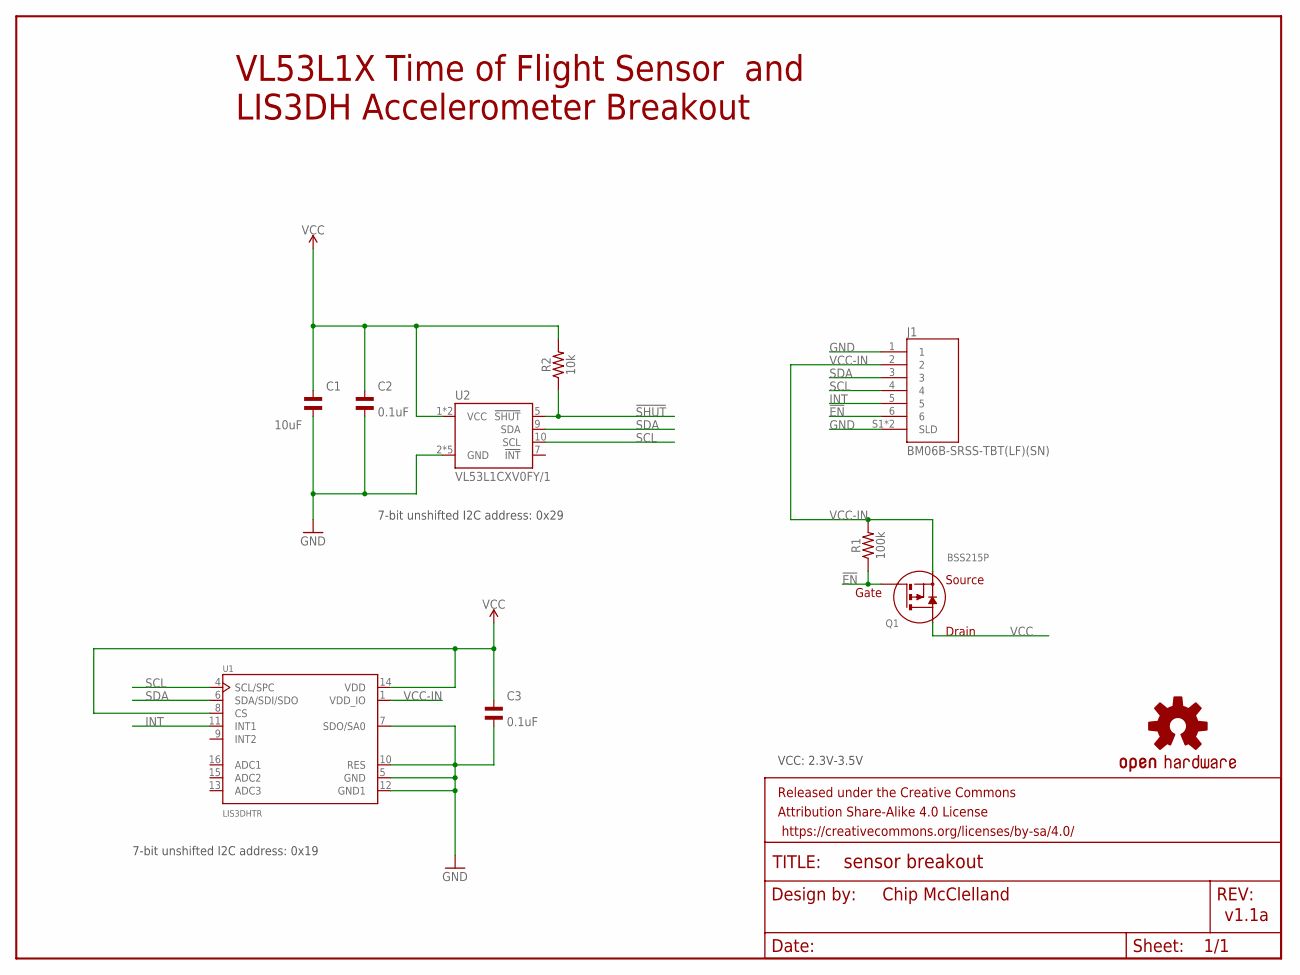
[picture p49: schematic Sensor Breakout.sch]

Parts:
C1: 10uF; C1206
C2, C3: 0.1uF; C0805
FRAME1: FRAME-LETTER; CREATIVE_COMMONS
J1: BM06B-SRSS-TBT(LF)(SN); JST_BM06B-SRSS-TB(LF)(SN)
LOGO1: OSHW-LOGOMINI; OSHW-LOGO-MINI
Q1: BSS215P; SOT-23_3L_ONS-M
R1: 100k; 0805; MPN MF-RES-0805-100K
R2: 10k; 0805
U1: LIS3DHTR; PQFN50P300X300X100-16N
U2: VL53L1CXV0FY/1; VL53L1X

Connections:
!EN: J1.6, Q1.1 (GATE), R1.1
!SHUT: R2.1, U2.5 (!SHUT)
GND: C1.P$2, C2.P$2, C3.P$2, J1.1, J1.S1 (SLD), J1.S2 (SLD), U1.5 (GND), U1.7 (SDO/SA0), U1.10 (RES), U1.12 (GND1), U2.2 (GND), U2.3 (GND), U2.4 (GND), U2.6 (GND), U2.12 (GND)
INT: J1.5, U1.11 (INT1)
SCL: J1.4, U1.4 (SCL/SPC), U2.10 (SCL)
SDA: J1.3, U1.6 (SDA/SDI/SDO), U2.9 (SDA)
VCC: C1.P$1, C2.P$1, C3.P$1, Q1.3 (DRAIN), R2.2, U1.8 (CS), U1.14 (VDD), U2.1 (VCC), U2.11 (VCC)
VCC-IN: J1.2, Q1.2 (SOURCE), R1.2, U1.1 (VDD_IO)

Notes on the sheet:
Chip McClelland
v1.1a
7-bit unshifted I2C address: 0x29
VCC: 2.3V-3.5V
VL53L1X Time of Flight Sensor and LIS3DH Accelerometer Breakout
7-bit unshifted I2C address: 0x19

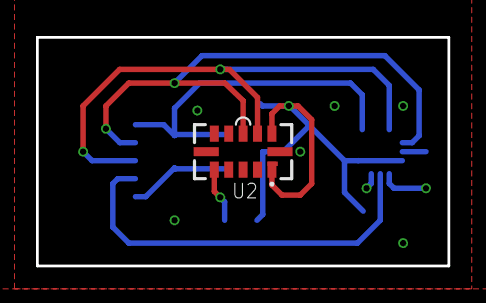
[picture p50: board Sensor Breakout.brd from above]

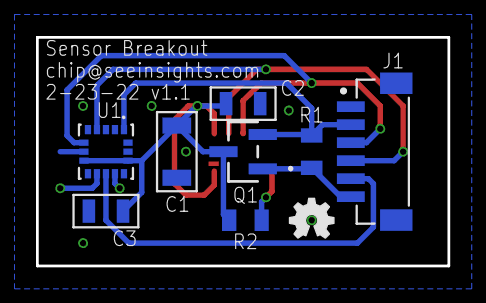
[picture p51: board Sensor Breakout.brd from below]

Board: 2 copper layers, 22.9 x 12.7 mm, 11 parts (9 on the bottom side), 8 nets.
