See-Insights/Trashcan-Panda-Hardware/Trasncan-Panda-Carrier-Board/Carrier Board.brd

## EAGLE design Trasncan-Panda-Carrier-Board/Carrier Board.brd (2022-02-23)

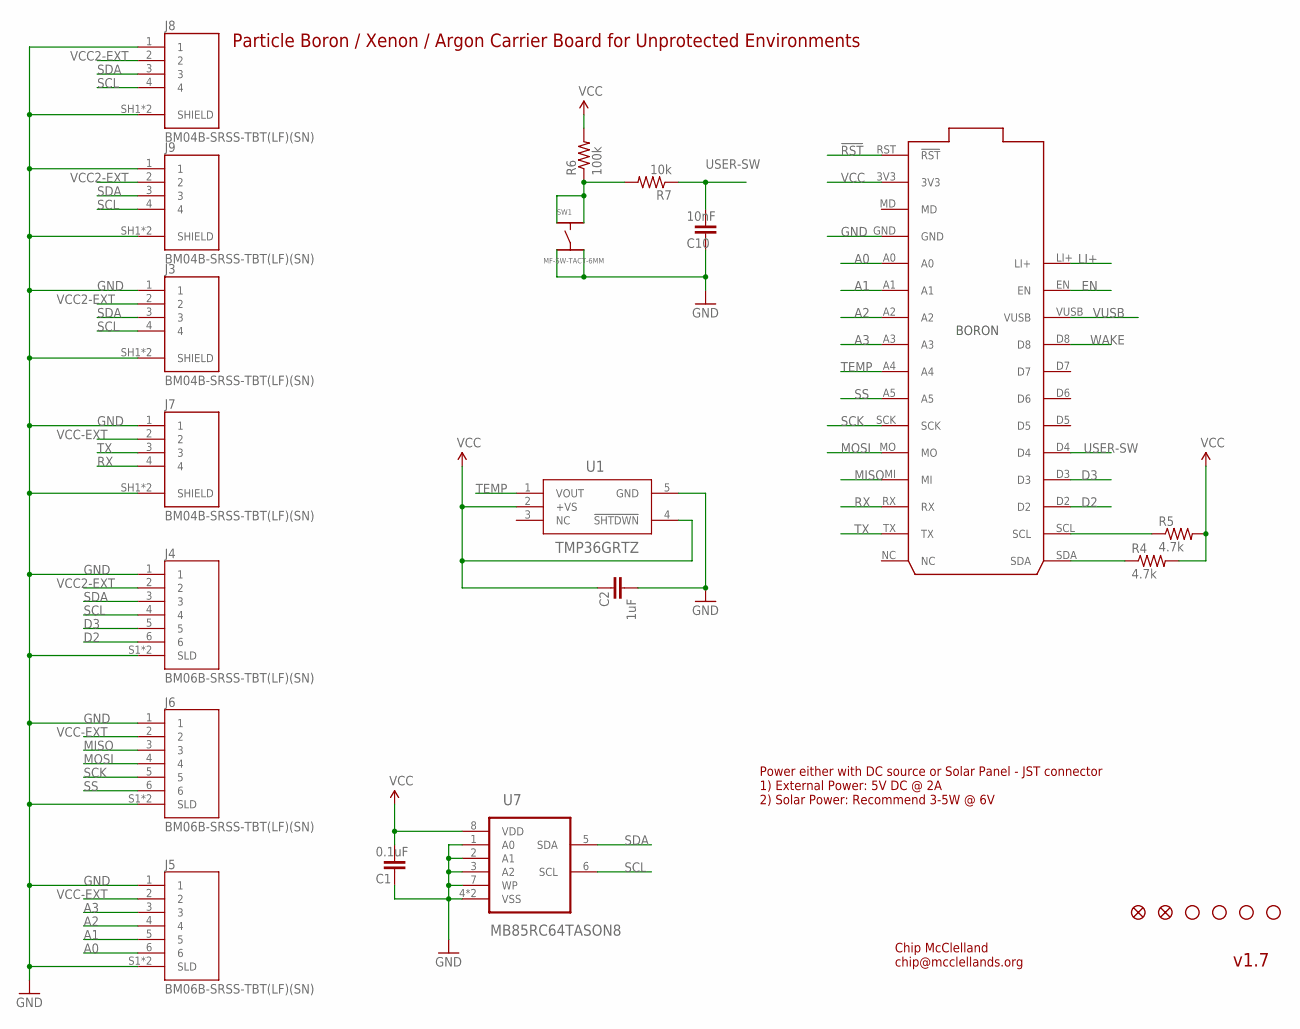
[picture p52: schematic Carrier Board.sch, sheet 1, Sensors]

Parts:
C1: 0.1uF; 0805@1; MPN MF-CAP-0805-0.1uF
C2: 1uF; 0805@1; MPN MF-CAP-0805-1uF
C10: 10nF; 0805@1; MPN 08051C103K4T2A
FD1, FD2: FIDUCIALUFIDUCIAL; FIDUCIAL-MICRO
J3, J7, J8, J9: BM04B-SRSS-TBT(LF)(SN); CONN_BM04B-SRSS-TBT(LF)(SN)
J4, J5, J6: BM06B-SRSS-TBT(LF)(SN); JST_BM06B-SRSS-TB(LF)(SN)
JP3, JP4, JP5, JP6: STAND-OFF
P1: Particle Boron / Xenon / Argon; PARTICLE-DEVICES_BORON
R4, R5: 4.7k; 0805; MPN MF-RES-0805-4.7K
R6: 100k; 0805; MPN MF-RES-0805-100K
R7: 10k; 0805; MPN MF-RES-0805-10K
SW1: MF-SW-TACT-6MM; TACT6MM
U1: TMP36GRTZ; RJ_5_ADI; MANUFACTURER_PART_NUMBER TMP36GRTZ-REEL7
U7: MB85RC64TASON8; SON50P200X300X75-9N

Connections:
!RST: P1.RST (!RST); also elsewhere on the board
A0: J5.6, P1.A0
A1: J5.5, P1.A1
A2: J5.4, P1.A2
A3: J5.3, P1.A3
D2: J4.6, P1.D2; also elsewhere on the board
D3: J4.5, P1.D3; also elsewhere on the board
EN: P1.EN; also elsewhere on the board
GND: C1.2, C2.2, C10.2, J3.1, J3.SH1 (SHIELD), J3.SH2 (SHIELD), J4.1, J4.S1 (SLD), J4.S2 (SLD), J5.1, J5.S1 (SLD), J5.S2 (SLD), J6.1, J6.S1 (SLD), J6.S2 (SLD), J7.1, J7.SH1 (SHIELD), J7.SH2 (SHIELD), J8.1, J8.SH1 (SHIELD), J8.SH2 (SHIELD), J9.1, J9.SH1 (SHIELD), J9.SH2 (SHIELD), P1.GND, SW1.P$3, SW1.P$4, U1.5 (GND), U7.1 (A0), U7.2 (A1), U7.3 (A2), U7.4 (VSS), U7.7 (WP), U7.9 (VSS); also elsewhere on the board
LI+: P1.LI+; also elsewhere on the board
MISO: J6.3, P1.MI
MOSI: J6.4, P1.MO
unnamed: R6.1, R7.2, SW1.P$1, SW1.P$2
RX: J7.4, P1.RX
SCK: J6.5, P1.SCK
SCL: J3.4, J4.4, J8.4, J9.4, P1.SCL, R5.1, U7.6 (SCL); also elsewhere on the board
SDA: J3.3, J4.3, J8.3, J9.3, P1.SDA, R4.1, U7.5 (SDA); also elsewhere on the board
SS: J6.6, P1.A5
TEMP: P1.A4, U1.1 (VOUT)
TX: J7.3, P1.TX
USER-SW: C10.1, P1.D4, R7.1
VCC: C1.1, C2.1, P1.3V3, R4.2, R5.2, R6.2, U1.2 (+VS), U1.4 (!SHTDWN), U7.8 (VDD); also elsewhere on the board
VCC2-EXT: J3.2, J4.2, J8.2, J9.2; also elsewhere on the board
VCC-EXT: J5.2, J6.2, J7.2; also elsewhere on the board
VUSB: P1.VUSB; also elsewhere on the board
WAKE: P1.D8; also elsewhere on the board

Notes on the sheet:
Chip McClelland chip@mcclellands.org
v1.7
Power either with DC source or Solar Panel - JST connector 1) External Power: 5V DC @ 2A 2) Solar Power: Recommend 3-5W @ 6V
Particle Boron / Xenon / Argon Carrier Board for Unprotected Environments

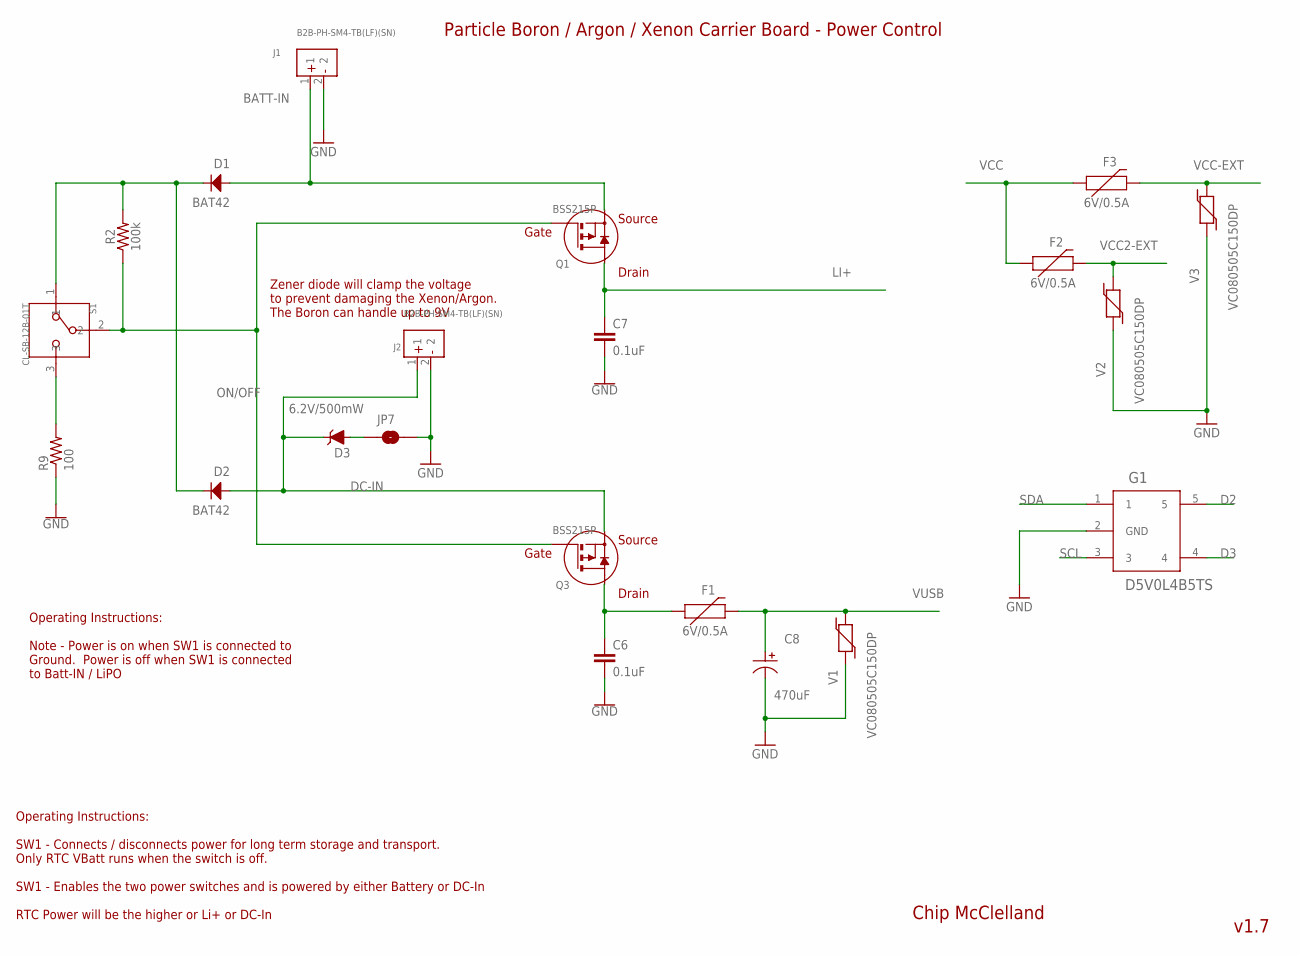
[picture p53: schematic Carrier Board.sch, sheet 2, Power Control]

Parts:
C6, C7: 0.1uF; 0805@1; MPN MF-CAP-0805-0.1uF
C8: 470uF; CP10MM; MPN MF-CAP-10MM-470uF
D1, D2: BAT42; SOD-123
D3: 6.2V/500mW; PANASONIC_SMINI2-F5-B; MPN TDZ6V2J,115
F1: 6V/0.5A; 1206; MPN 046801.5NR
F2, F3: 6V/0.5A; 1206; MPN 0466.500NR
G1: D5V0L4B5TS; SOT-23-5; MPN D5V0L4B5TS-7
J1, J2: B2B-PH-SM4-TB(LF)(SN); JST_B2B-PH-SM4-TB(LF)(SN)
JP7: JUMPER-SMT_2_NO_SILK; SMT-JUMPER_2_NO_SILK
Q1, Q3: BSS215P; SOT-23_3L_ONS-M
R2: 100k; 0805
R9: 100; 0805; MPN MF-RES-0805-100
S1: CL-SB-12B-01T; CL-SB-12B
V1, V2, V3: VC080505C150DP; 0805; MPN VC080505C150DP

Connections:
BATT-IN: D1.ANODE, J1.1, Q1.2 (SOURCE); also elsewhere on the board
D2: G1.5; also elsewhere on the board
D3: G1.4; also elsewhere on the board
DC-IN: D2.ANODE, D3.C, J2.1, Q3.2 (SOURCE)
GND: C6.2, C7.2, C8.P$2, G1.2 (GND), J1.2, J2.2, JP7.1, R9.1, V1.1, V2.1, V3.1; also elsewhere on the board
LI+: C7.1, Q1.3 (DRAIN); also elsewhere on the board
unnamed: D3.A, JP7.2
unnamed: C6.1, F1.1, Q3.3 (DRAIN)
unnamed: D1.CATHODE, D2.CATHODE, R2.2, S1.1
unnamed: R9.2, S1.3
ON/OFF: Q1.1 (GATE), Q3.1 (GATE), R2.1, S1.2
SCL: G1.3; also elsewhere on the board
SDA: G1.1; also elsewhere on the board
VCC: F2.1, F3.1; also elsewhere on the board
VCC2-EXT: F2.2, V2.2; also elsewhere on the board
VCC-EXT: F3.2, V3.2; also elsewhere on the board
VUSB: C8.P$1, F1.2, V1.2; also elsewhere on the board

Notes on the sheet:
Particle Boron / Argon / Xenon Carrier Board - Power Control
Chip McClelland
v1.7
Operating Instructions: SW1 - Connects / disconnects power for long term storage and transport. Only RTC VBatt runs when the switch is off. SW1 - Enables the two power switches and is powered by either Battery or DC-In RTC Power will be the higher or Li+ or DC-In
Zener diode will clamp the voltage to prevent damaging the Xenon/Argon. The Boron can handle up to 9V
Operating Instructions: Note - Power is on when SW1 is connected to Ground. Power is off when SW1 is connected to Batt-IN / LiPO

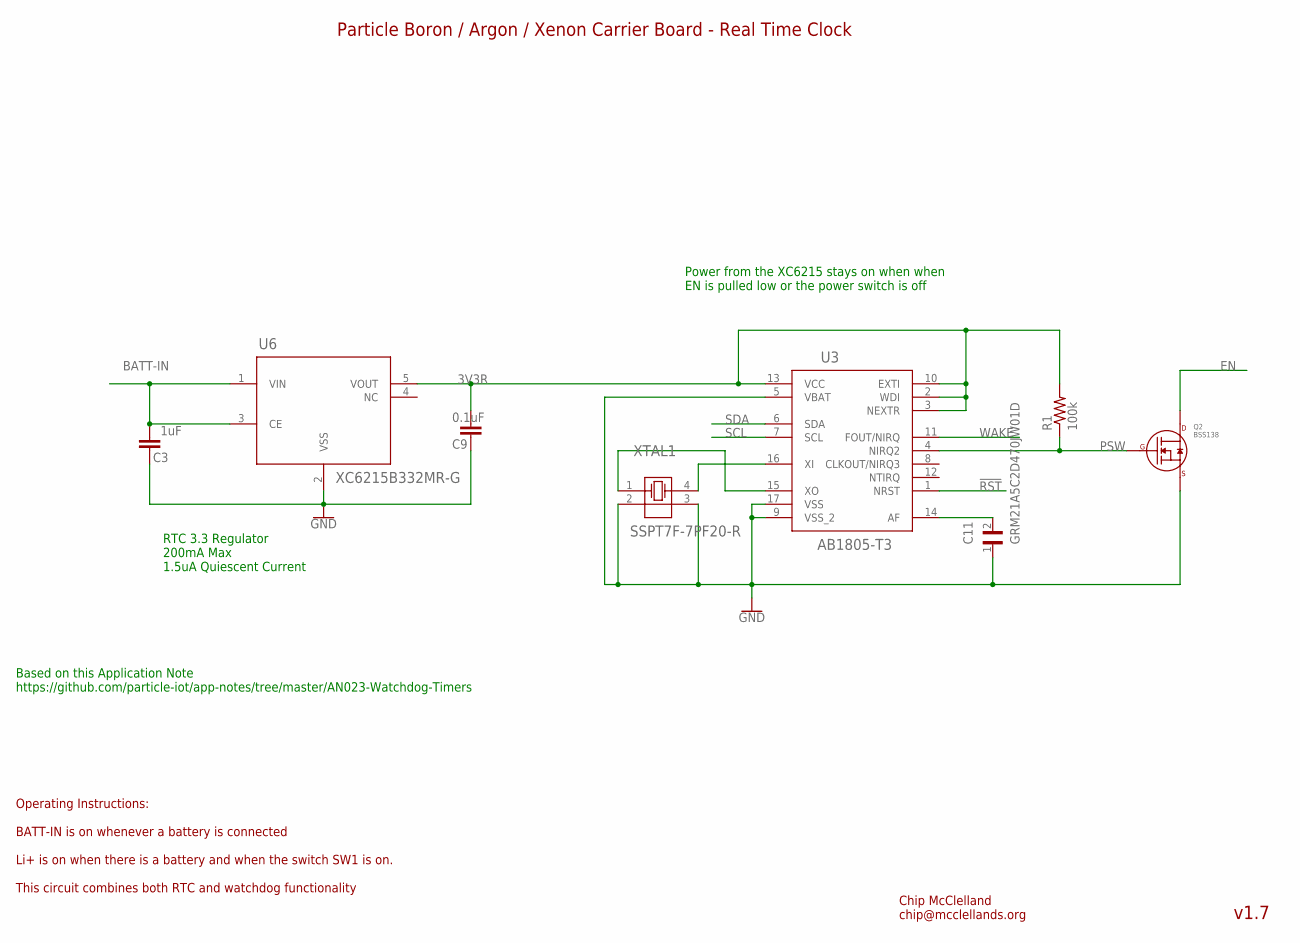
[picture p54: schematic Carrier Board.sch, sheet 3, Real Time Clock]

Parts:
C3: 1uF; 0805@1; MPN MF-CAP-0805-1uF
C9: 0.1uF; 0805@1; MPN MF-CAP-0805-0.1uF
C11: GRM21A5C2D470JW01D; CAPC2012X100N
Q2: BSS138; SOT-23_3L_ONS
R1: 100k; 0805; MPN MF-RES-0805-100K
U3: AB1805-T3; QFN_16_ABR
U6: XC6215B332MR-G; SOT-25_TOR
XTAL1: SSPT7F-7PF20-R; SSP-T7-F_EPS

Connections:
3V3R: C9.1, R1.2, U3.2 (WDI), U3.3 (NEXTR), U3.10 (EXTI), U3.13 (VCC), U6.5 (VOUT)
!RST: U3.1 (NRST); also elsewhere on the board
BATT-IN: C3.2, U6.1 (VIN), U6.3 (CE); also elsewhere on the board
EN: Q2.3 (DRAIN); also elsewhere on the board
GND: C3.1, C9.2, C11.1, Q2.2 (SOURCE), U3.5 (VBAT), U3.9 (VSS_2), U3.17 (VSS), U6.2 (VSS), XTAL1.2, XTAL1.3; also elsewhere on the board
unnamed: U3.15 (XO), XTAL1.1
unnamed: U3.16 (XI), XTAL1.4
unnamed: C11.2, U3.14 (AF)
PSW: Q2.1 (GATE), R1.1, U3.4 (NIRQ2)
SCL: U3.7 (SCL); also elsewhere on the board
SDA: U3.6 (SDA); also elsewhere on the board
WAKE: U3.11 (FOUT/NIRQ); also elsewhere on the board

Notes on the sheet:
Operating Instructions: BATT-IN is on whenever a battery is connected Li+ is on when there is a battery and when the switch SW1 is on. This circuit combines both RTC and watchdog functionality
Particle Boron / Argon / Xenon Carrier Board - Real Time Clock
Chip McClelland chip@mcclellands.org
v1.7
RTC 3.3 Regulator 200mA Max 1.5uA Quiescent Current
Power from the XC6215 stays on when when EN is pulled low or the power switch is off
Based on this Application Note https://github.com/particle-iot/app-notes/tree/master/AN023-Watchdog-Timers

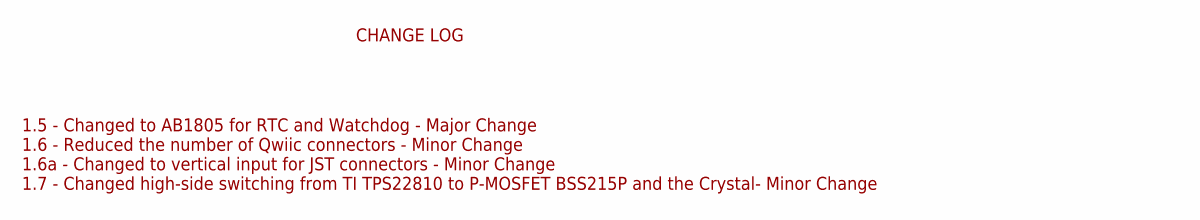
[picture p55: schematic Carrier Board.sch, sheet 4]

Notes on the sheet:
CHANGE LOG
1.5 - Changed to AB1805 for RTC and Watchdog - Major Change 1.6 - Reduced the number of Qwiic connectors - Minor Change 1.6a - Changed to vertical input for JST connectors - Minor Change 1.7 - Changed high-side switching from TI TPS22810 to P-MOSFET BSS215P and the Crystal- Minor Change

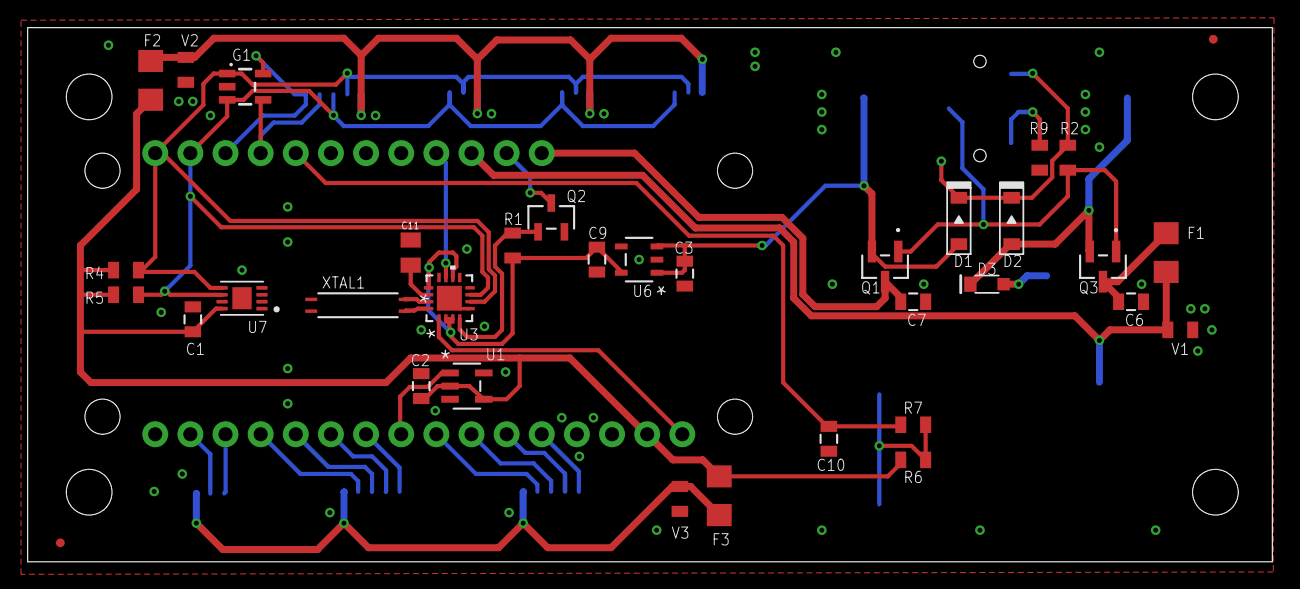
[picture p56: board Carrier Board.brd from above]

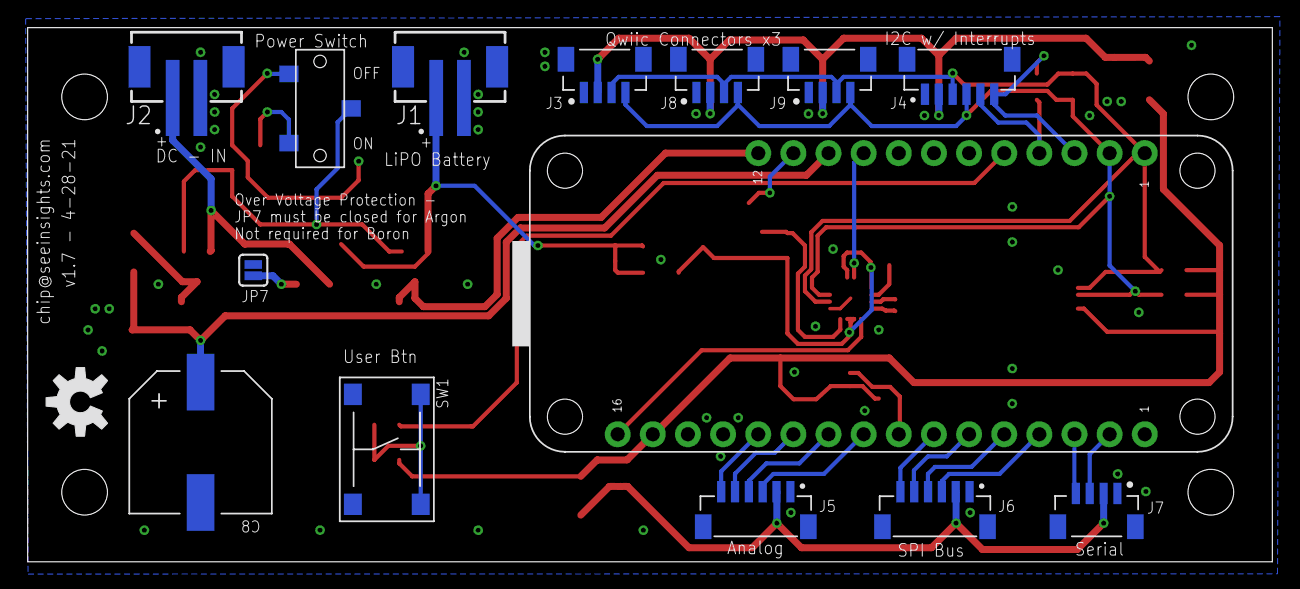
[picture p57: board Carrier Board.brd from below]

Board: 2 copper layers, 90.0 x 38.6 mm, 54 parts (15 on the bottom side), 38 nets.

Other parts of the board:
U$2: OSHW-LOGO-M
