See-Insights/Trashcan-Panda-Hardware/OTII-ARC-Breakout/OTII-Breakout.brd

## EAGLE design OTII-ARC-Breakout/OTII-Breakout.brd (2022-02-19)

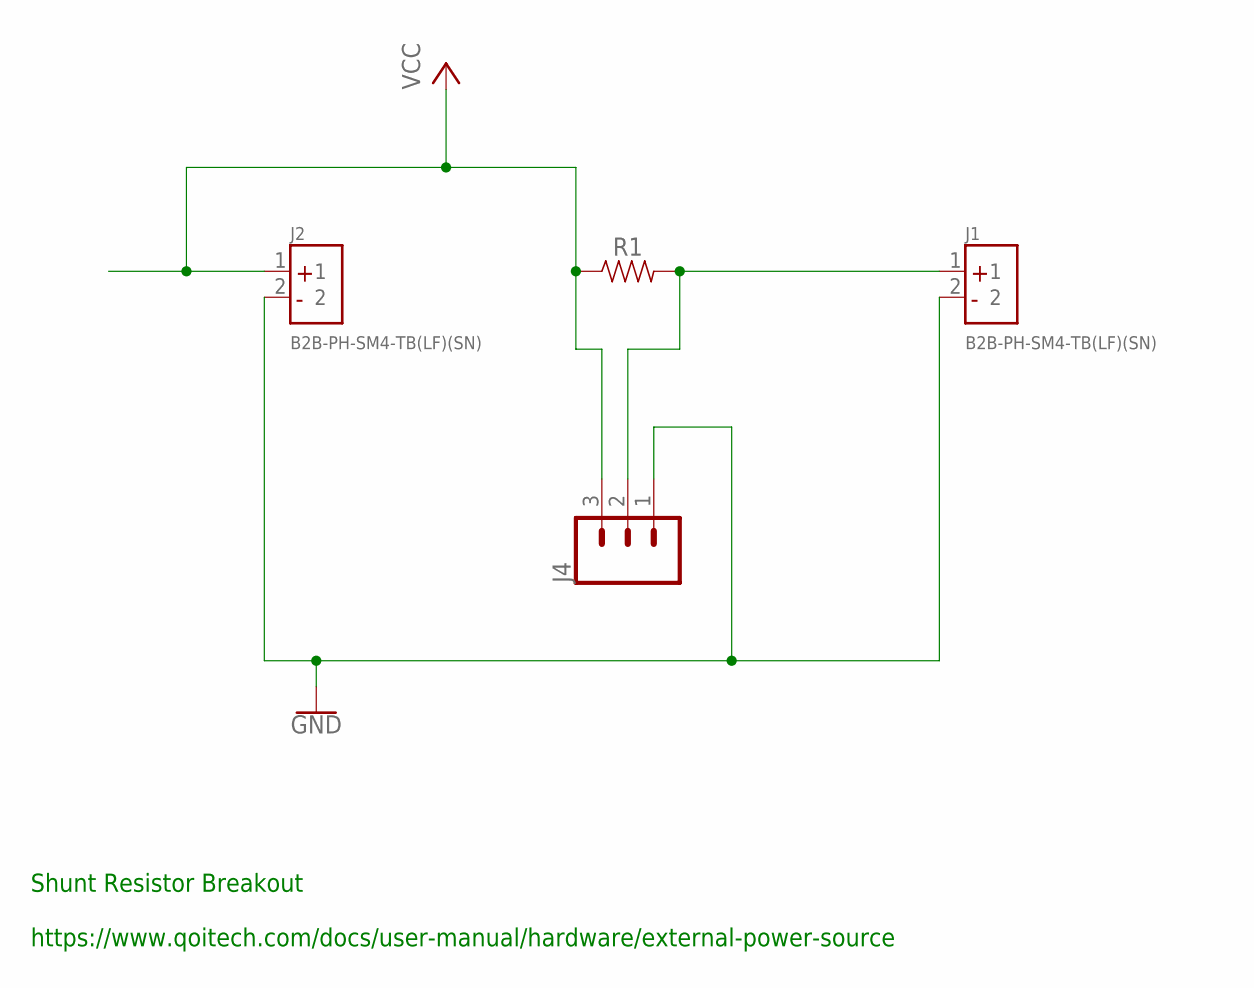
[picture p58: schematic OTII-Breakout.sch]

Parts:
J1, J2: B2B-PH-SM4-TB(LF)(SN); JST_B2B-PH-SM4-TB(LF)(SN)
J4: CONN_03; 1X03
R1: 0805

Connections:
GND: J1.2, J2.2, J4.1
unnamed: J1.1, J4.2, R1.2
VCC: J2.1, J4.3, R1.1

Notes on the sheet:
Shunt Resistor Breakout https://www.qoitech.com/docs/user-manual/hardware/external-power-source

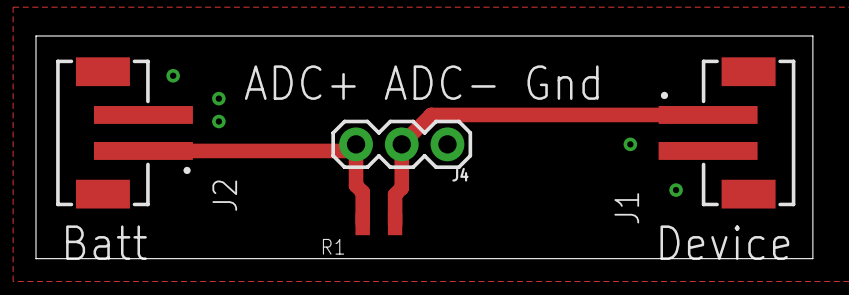
[picture p59: board OTII-Breakout.brd from above]

Board: 2 copper layers, 43.2 x 12.4 mm, 4 parts (0 on the bottom side), 3 nets.
