See-Insights/Trashcan-Panda-Hardware/Trashcan-Panda Sensor-Board/VL53L1X-TOF-Sensor.brd

## EAGLE design Trashcan-Panda Sensor-Board/VL53L1X-TOF-Sensor.brd (2022-02-18)

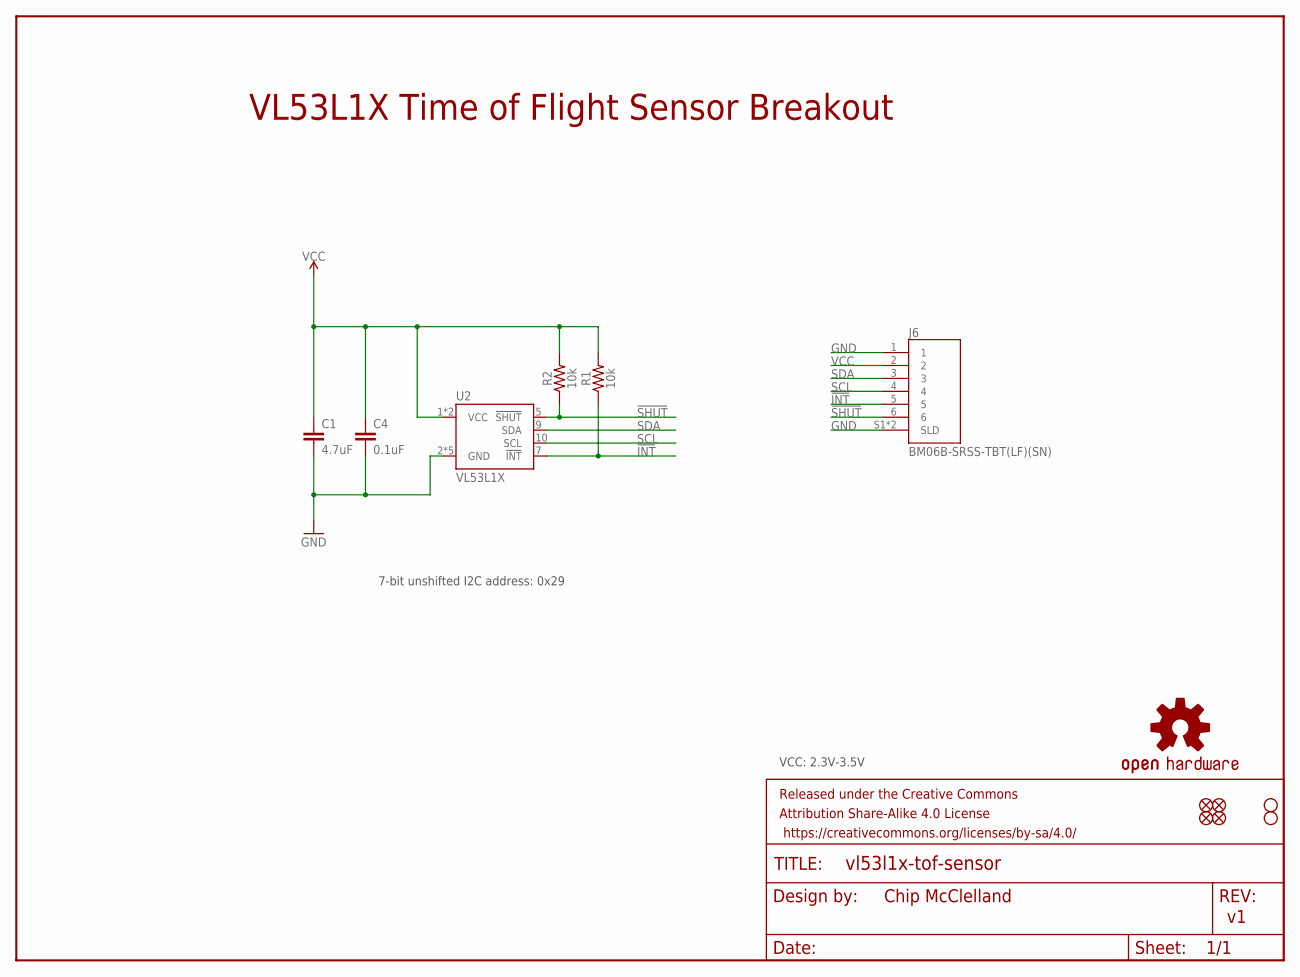
[picture p60: schematic VL53L1X-TOF-Sensor.sch]

Parts:
C1: 4.7uF; 0603
C4: 0.1uF; 0603
FRAME1: FRAME-LETTER; CREATIVE_COMMONS
J6: BM06B-SRSS-TBT(LF)(SN); JST_BM06B-SRSS-TB(LF)(SN)
JP1, JP2, JP5, JP6: FIDUCIALUFIDUCIAL; MICRO-FIDUCIAL
JP3, JP4: STAND-OFF
LOGO1: OSHW-LOGOMINI; OSHW-LOGO-MINI
R1, R2: 10k; 0603
U2: VL53L1X

Connections:
!INT: J6.5, R1.1, U2.7 (!INT)
!SHUT: J6.6, R2.1, U2.5 (!SHUT)
GND: C1.2, C4.2, J6.1, J6.S1 (SLD), J6.S2 (SLD), U2.2 (GND), U2.3 (GND), U2.4 (GND), U2.6 (GND), U2.12 (GND)
SCL: J6.4, U2.10 (SCL)
SDA: J6.3, U2.9 (SDA)
VCC: C1.1, C4.1, J6.2, R1.2, R2.2, U2.1 (VCC), U2.11 (VCC)

Notes on the sheet:
Chip McClelland
7-bit unshifted I2C address: 0x29
VCC: 2.3V-3.5V
VL53L1X Time of Flight Sensor Breakout

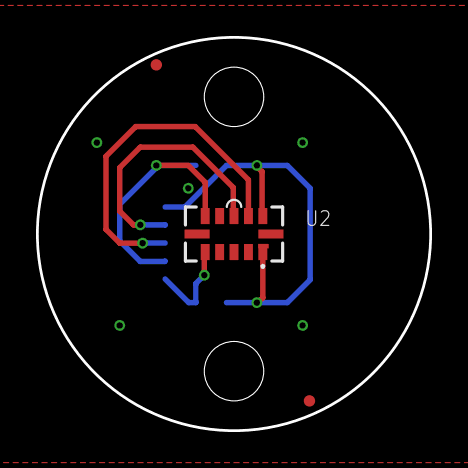
[picture p61: board VL53L1X-TOF-Sensor.brd from above]

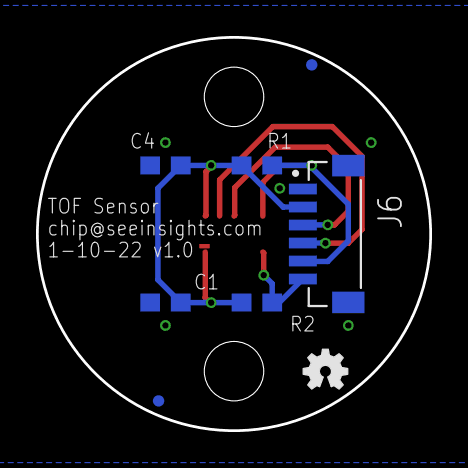
[picture p62: board VL53L1X-TOF-Sensor.brd from below]

Board: 2 copper layers, 21.8 x 21.8 mm, 14 parts (8 on the bottom side), 6 nets.
