See-Insights/Trashcan-Panda-Hardware/(commit log)

2022-02-19 Updates for breakout board
    [Battery-Board.brd, Battery-Board.sch, OTII-Breakout.brd, OTII-Breakout.sch]
2022-02-23 Rectangular Sensor Board
    [Carrier Board.brd, Carrier Board.sch, Sensor Breakout.brd, Sensor Breakout.sch]
2022-03-14 Updated battery board to v1.1
    [Battery-Board.brd, Battery-Board.sch, Sensor Breakout.brd, Sensor Breakout.sch]
2022-03-17 Updated - Grounded address pin
    [Sensor Breakout.brd, Sensor Breakout.sch]
2022-03-17 Changed Battery Board Profile
    [Battery-Board.brd, Battery-Board.sch]
2022-03-21 Updated for Macrofab house parts
    [Sensor Breakout.brd, Sensor Breakout.sch]
2022-03-30 Added pictures as case evolves
2022-04-09 Added PTC
    [Battery-Board.brd, Battery-Board.sch, Sensor Breakout.brd, Sensor Breakout.sch]
2022-04-29 Adding assembled device photos
