See-Insights/Trashcan-Panda-Hardware/(notices)

Notices in the files:
parts and their libraries:
SparkFun-Connectors: Licensing: Creative Commons ShareAlike 4.0 International - https://creativecommons.org/licenses/by-sa/4.0
Custom Components: COPYRIGHT: Copyright (C) 2018 Accelerated Designs. All rights reserved
SparkFun-Aesthetics: https://creativecommons.org/licenses/by-sa/4.0
